JohnRSmith101/rocket-tracker/hardware/kicad/Gimbal_Controller_Box_R1/Gimbal Controller Box R1.jpg

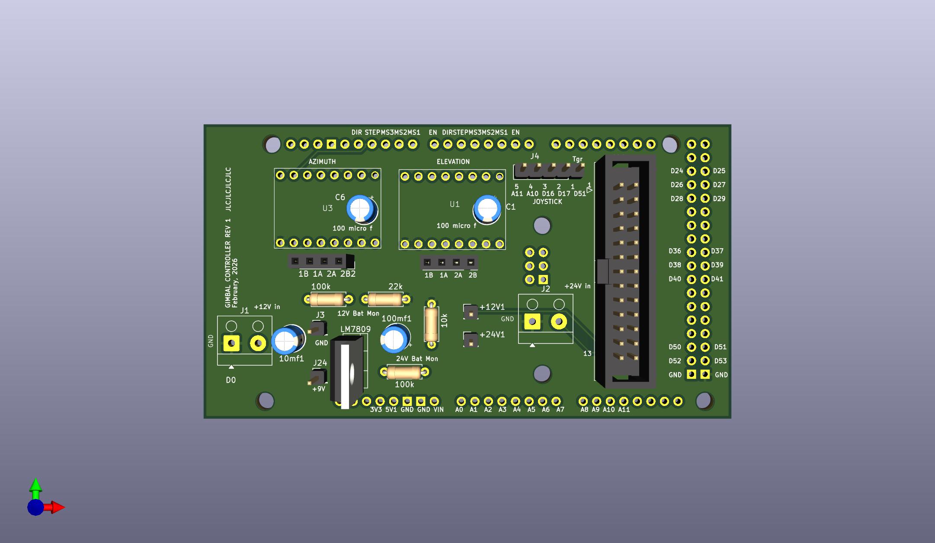
hardware/kicad/Gimbal_Controller_Box_R1/Gimbal Controller Box R1.jpg
