JohnRSmith101/rocket-tracker/hardware/kicad/Gimbal_Controller_Lid/Gimbal Controller Lid.jpg

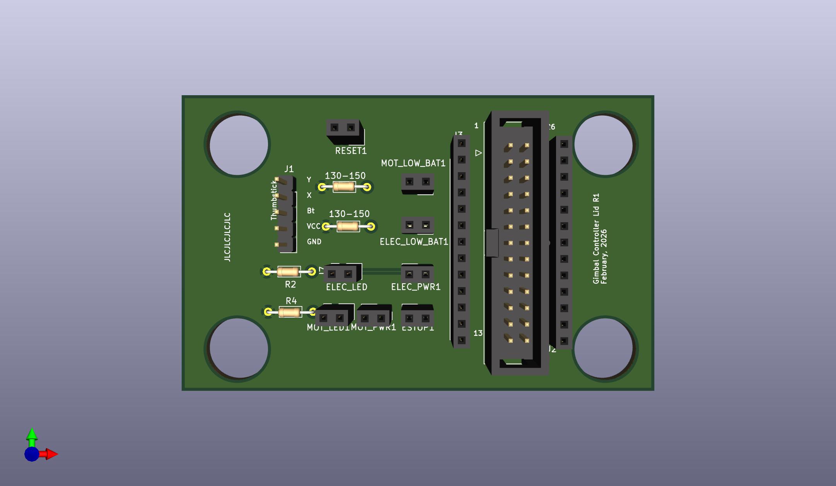
hardware/kicad/Gimbal_Controller_Lid/Gimbal Controller Lid.jpg
