JohnRSmith101/rocket-tracker/LICENSES/README.md

# License texts

| File | License | Applies to |
|---|---|---|
| `Apache-2.0.txt` | Apache License 2.0 | Arduino sketches, TFLite tracker, TFLite/MediaPipe models |
| `AGPL-3.0-only.txt` | GNU AGPL v3 | YOLO tracker and YOLO models |
| `CC-BY-SA-4.0.txt` | CC BY-SA 4.0 | Build Book, KiCad, STL, photos, drawings, datasets |
| `MIT-RamadityaK.txt` | MIT (third party) | Notice for PiMediapipeObjectDetection by Ramaditya Kotha |

See `../LICENSE` for which license applies to which folder.
