JohnRSmith101/rocket-tracker/models/mediapipe-dec2024/training-records/colab_log_earlier_small_dataset_rocket8_166_images.pdf

### You are subscribed to

Colab Pro.

### Learn more (https://colab.research.google.com/signup?authuser=1) Available:

143.81

### compute units Usage rate: approximately 0 per hour You have 0 active

sessions.

### Not connected

to runtime.

OOppeenn iinn CCoollaabb (https://colab.research.google.com/github/khanhlvg/tflite_raspberry_pi/blob/main/object_detection/Train_custom_model_tutorial.ipynb)

- Copyright 2023 The MediaPipe Authors.

# Licensed under the Apache License, Version 2.0 (the

"License");

### Show code

In this colab notebook, you'll learn how to use MediaPipe Model Maker (https://developers.google.com/mediapipe/solutions/model_maker) to train a custom object detection model to detect dogs.

## The Model Maker library uses transfer learning to simplify the process of training a TensorFlow Lite model using a custom dataset to use with the

MediaPipe Object Detector task. (https://developers.google.com/mediapipe/solutions/vision/object_detector)

# Train a custom object detection model with MediaPipe Model Maker

# Install the required packages

## Start by installing the required packages, including the Model Maker package

from the GitHub repo (https://github.com/google/mediapipe/tree/master/mediapipe/model_maker) and the pycocotools library you'll use for evaluation.

# - Preparation

Start coding or generate with AI.

Collecting colorama (from sacrebleu->tf-models-official<2.16.0,>=2.13.2->mediapipe-model-maker)

### Downloading colorama-0.4.6-py2.py3-none-any.whl.metadata (17 kB)

Requirement already satisfied: lxml in /usr/local/lib/python3.10/dist-packages (from sacrebleu->tf-models-official<2.16.0,>=2.13.2->mediapipe-model-maker) (5.3.0)
Requirement already satisfied: scikit-learn>=0.21.3 in /usr/local/lib/python3.10/dist-packages (from seqeval->tf-models-official<2.16.0,>=2.13.2->mediapipe-model-maker) (1.5.2)

### !pip install --upgrade pip !pip install 'keras<3.0.0' mediapipe-model-maker

### Manage sessions

### Change runtime type

### Resources

Requirement already satisfied: docstring-parser<1.0,>=0.15 in /usr/local/lib/python3.10/dist-packages (from simple-parsing->tensorflow-datasets->mediapipe-model-maker) (0.16)
Requirement already satisfied: googleapis-common-protos<2,>=1.52.0 in /usr/local/lib/python3.10/dist-packages (from tensorflow-metadata->tensorflow-datasets->mediapipe-model-maker) (1.66.0)
Requirement already satisfied: pycparser in /usr/local/lib/python3.10/dist-packages (from CFFI>=1.0->sounddevice>=0.4.4->mediapipe>=0.10.0->mediapipe-model-maker) (2.22)
Requirement already satisfied: proto-plus<2.0.0dev,>=1.22.3 in /usr/local/lib/python3.10/dist-packages (from google-api-core!=2.0.*,!=2.1.*,!=2.2.*,!=2.3.0,<3.0.0.dev0,>=1.31.5->google-api-python-client>=1.6.7->tf-models-official<2.16.0,>=2.13.2->mediapipe-model-maker) (1.25.0) Requirement already satisfied: cachetools<6.0,>=2.0.0 in /usr/local/lib/python3.10/dist-packages (from google-auth!=2.24.0,!=2.25.0,<3.0.0.dev0,>=1.32.0->google-api-python-client>=1.6.7->tf-models-official<2.16.0,>=2.13.2->mediapipe-model-maker) (5.5.0)
Requirement already satisfied: requests-oauthlib>=0.7.0 in /usr/local/lib/python3.10/dist-packages (from google-auth-oauthlib<2,>=0.5->tensorboard<2.16,>=2.15->tensorflow<2.16,>=2.10->mediapipe-model-maker) (1.3.1)
Requirement already satisfied: joblib>=1.2.0 in /usr/local/lib/python3.10/dist-packages (from scikit-learn>=0.21.3->seqeval->tf-models-official<2.16.0,>=2.13.2->mediapipe-model-maker) (1.4.2)
Requirement already satisfied: threadpoolctl>=3.1.0 in /usr/local/lib/python3.10/dist-packages (from scikit-learn>=0.21.3->seqeval->tf-models-official<2.16.0,>=2.13.2->mediapipe-model-maker) (3.5.0)
Requirement already satisfied: MarkupSafe>=2.1.1 in /usr/local/lib/python3.10/dist-packages (from werkzeug>=1.0.1->tensorboard<2.16,>=2.15->tensorflow<2.16,>=2.10->mediapipe-model-maker) (3.0.2)
Requirement already satisfied: webencodings in /usr/local/lib/python3.10/dist-packages (from bleach->kaggle>=1.3.9->tf-models-official<2.16.0,>=2.13.2->mediapipe-model-maker) (0.5.1)
Requirement already satisfied: text-unidecode>=1.3 in /usr/local/lib/python3.10/dist-packages (from python-slugify->kaggle>=1.3.9->tf-models-official<2.16.0,>=2.13.2->mediapipe-model-maker) (1.3)
Requirement already satisfied: oauthlib>=3.0.0 in /usr/local/lib/python3.10/dist-packages (from requests-oauthlib>=0.7.0->google-auth-oauthlib<2,>=0.5->tensorboard<2.16,>=2.15->tensorflow<2.16,>=2.10->mediapipe-model-maker) (3.2.2)

Downloading keras-2.15.0-py3-none-any.whl (1.7 MB) ━━━━━━━━━━━━━━━━━━━━━━━━━━━━━━━━━━━━━━━━ 1.7/1.7 MB 40.5 MB/s Downloading mediapipe_model_maker-0.2.1.4-py3-none-any.whl (133 kB) Downloading mediapipe-0.10.20-cp310-cp310-manylinux_2_28_x86_64.whl (35.6 MB) ━━━━━━━━━━━━━━━━━━━━━━━━━━━━━━━━━━━━━━━━ 35.6/35.6 MB 107.3 MB/s

Downloading tensorflow-2.15.1-cp310-cp310-manylinux_2_17_x86_64.manylinux2014_x86_64.whl (475.2 MB)

### ━━━━━━━━━━━━━━━━━━━━━━━━━━━━━━━━━━━━━━━━ 475.2/475.2 MB 49.7 MB/s Downloading tensorflow_model_optimization-0.7.5-py2.py3-none-any.whl (241 kB) Downloading tf_models_official-2.15.0-py2.py3-none-any.whl (2.7 MB) ━━━━━━━━━━━━━━━━━━━━━━━━━━━━━━━━━━━━━━━━ 2.7/2.7 MB 61.9 MB/s

Downloading tensorflow_text-2.15.0-cp310-cp310-manylinux_2_17_x86_64.manylinux2014_x86_64.whl (5.2 MB)

### ━━━━━━━━━━━━━━━━━━━━━━━━━━━━━━━━━━━━━━━━ 5.2/5.2 MB 73.5 MB/s

Downloading tensorflow_addons-0.23.0-cp310-cp310-manylinux_2_17_x86_64.manylinux2014_x86_64.whl (611 kB)

### ━━━━━━━━━━━━━━━━━━━━━━━━━━━━━━━━━━━━━━━━ 611.8/611.8 kB 25.5 MB/s

Downloading ml_dtypes-0.3.2-cp310-cp310-manylinux_2_17_x86_64.manylinux2014_x86_64.whl (2.2 MB)

━━━━━━━━━━━━━━━━━━━━━━━━━━━━━━━━━━━━━━━━ 2.2/2.2 MB 65.1 MB/s Downloading sounddevice-0.5.1-py3-none-any.whl (32 kB) Downloading tensorboard-2.15.2-py3-none-any.whl (5.5 MB) ━━━━━━━━━━━━━━━━━━━━━━━━━━━━━━━━━━━━━━━━ 5.5/5.5 MB 90.3 MB/s Downloading tensorflow_estimator-2.15.0-py2.py3-none-any.whl (441 kB) Downloading tf_keras-2.15.1-py3-none-any.whl (1.7 MB) ━━━━━━━━━━━━━━━━━━━━━━━━━━━━━━━━━━━━━━━━ 1.7/1.7 MB 61.2 MB/s Downloading typeguard-2.13.3-py3-none-any.whl (17 kB)

Downloading wrapt-1.14.1-cp310-cp310-manylinux_2_5_x86_64.manylinux1_x86_64.manylinux_2_17_x86_64.manylinux2014_x86_64.whl (77 kB)

### Downloading sacrebleu-2.4.3-py3-none-any.whl (103 kB) Downloading colorama-0.4.6-py2.py3-none-any.whl (25 kB) Downloading portalocker-3.0.0-py3-none-any.whl (19 kB) Building wheels for collected packages: seqeval Building wheel for seqeval (setup.py) ... done

Created wheel for seqeval: filename=seqeval-1.2.2-py3-none-any.whl size=16161 sha256=df015b97a5ea490875526c99ecec4c3634c298cd50fbd425cc0a688eb1be956b
Stored in directory: /root/.cache/pip/wheels/1a/67/4a/ad4082dd7dfc30f2abfe4d80a2ed5926a506eb8a972b4767fa

### Successfully built seqeval

Installing collected packages: wrapt, typeguard, tensorflow-model-optimization, tensorflow-estimator, portalocker, ml-dtypes, keras, colorama, tensorflow-addons, sounddevice, sacrebleu, seqeval, tensorboard, mediapipe, tensorflow, tf-keras, tensorflow-text, tf-models-official, mediapipe-model-maker

### Attempting uninstall: wrapt Found existing installation: wrapt 1.17.0 Uninstalling wrapt-1.17.0: Successfully uninstalled wrapt-1.17.0 Attempting uninstall: typeguard Found existing installation: typeguard 4.4.1 Uninstalling typeguard-4.4.1: Successfully uninstalled typeguard-4.4.1

### Attempting uninstall: ml-dtypes

Import the required packages.

/usr/local/lib/python3.10/dist-packages/tensorflow_addons/utils/tfa_eol_msg.py:23: UserWarning:

TensorFlow Addons (TFA) has ended development and introduction | of new features.
TFA has entered a minimal maintenance and release mode until | a | planned end of life in May 2024.
Please modify downstream libraries to take dependencies from | other repositories | in our TensorFlow community (e.g. Keras, Keras-CV, and Keras-NLP).

### For more information see: https://github.com/tensorflow/addons/issues/2807

### warnings.warn(

### import os import tensorflow as tf assert tf.__version__.startswith('2') from google.colab import files

### from mediapipe_model_maker import object_detector

## This dataset contains about 130 images of 3 different dogs: a Golden Retriever, a Labrador Retriever mix, and a brindle-colored Formosan Mountain

Dog. This is an example image from the dataset.

# - Prepare the dataset

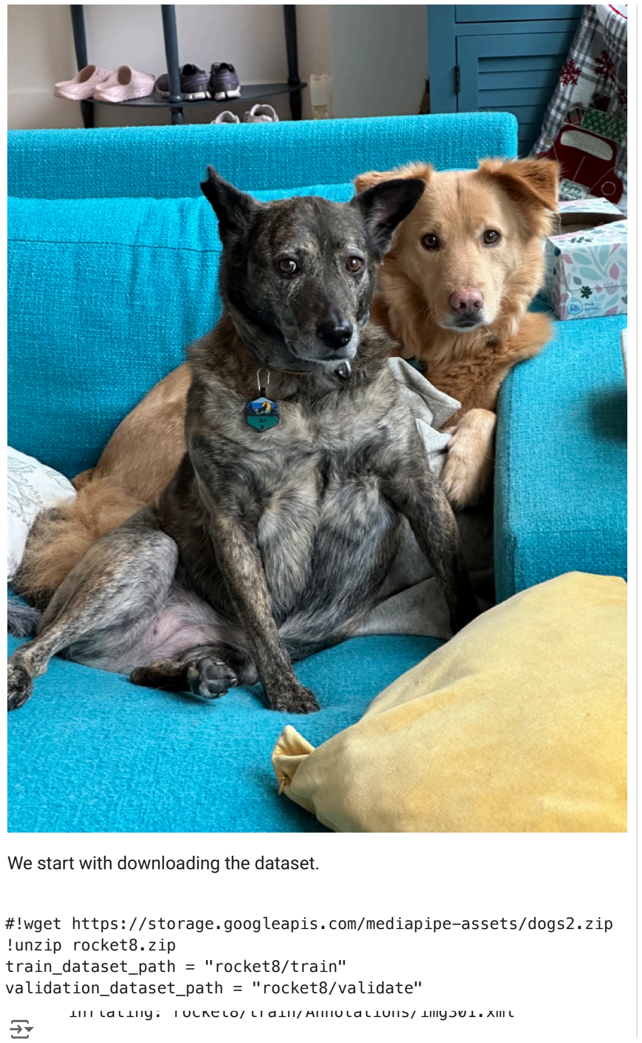
[picture p3: figure]
We start with downloading the dataset.; !unzip rocket8.zip train_dataset_path = "rocket8/train"

### inflating: rocket8/train/Annotations/img301.xml

### #!wget https://storage.googleapis.com/mediapipe-assets/dogs2.zip --no-check-certificate

### validation_dataset_path = "rocket8/validate"

inflating: __MACOSX/rocket8/train/Annotations/._img301.xml inflating: rocket8/train/Annotations/img329.xml inflating: __MACOSX/rocket8/train/Annotations/._img329.xml inflating: rocket8/train/Annotations/img117.xml inflating: __MACOSX/rocket8/train/Annotations/._img117.xml inflating: rocket8/train/Annotations/img103.xml inflating: __MACOSX/rocket8/train/Annotations/._img103.xml inflating: rocket8/train/Annotations/img129.xml inflating: __MACOSX/rocket8/train/Annotations/._img129.xml inflating: rocket8/train/Annotations/img115.xml inflating: __MACOSX/rocket8/train/Annotations/._img115.xml inflating: rocket8/train/Annotations/img101.xml inflating: __MACOSX/rocket8/train/Annotations/._img101.xml inflating: rocket8/train/Annotations/img459.xml inflating: __MACOSX/rocket8/train/Annotations/._img459.xml inflating: rocket8/train/Annotations/img471.xml inflating: __MACOSX/rocket8/train/Annotations/._img471.xml inflating: rocket8/train/Annotations/img303.xml inflating: __MACOSX/rocket8/train/Annotations/._img303.xml inflating: rocket8/train/Annotations/img465.xml inflating: __MACOSX/rocket8/train/Annotations/._img465.xml inflating: rocket8/train/Annotations/img539.xml inflating: __MACOSX/rocket8/train/Annotations/._img539.xml inflating: rocket8/train/Annotations/img505.xml inflating: __MACOSX/rocket8/train/Annotations/._img505.xml inflating: rocket8/train/Annotations/img263.xml inflating: __MACOSX/rocket8/train/Annotations/._img263.xml inflating: rocket8/train/Annotations/img277.xml inflating: __MACOSX/rocket8/train/Annotations/._img277.xml inflating: rocket8/train/Annotations/img511.xml inflating: __MACOSX/rocket8/train/Annotations/._img511.xml inflating: rocket8/train/Annotations/img288.xml inflating: __MACOSX/rocket8/train/Annotations/._img288.xml inflating: rocket8/train/Annotations/img289.xml inflating: __MACOSX/rocket8/train/Annotations/._img289.xml inflating: rocket8/train/Annotations/img276.xml inflating: __MACOSX/rocket8/train/Annotations/._img276.xml inflating: rocket8/train/Annotations/img510.xml inflating: __MACOSX/rocket8/train/Annotations/._img510.xml inflating: rocket8/train/Annotations/img504.xml inflating: __MACOSX/rocket8/train/Annotations/._img504.xml inflating: rocket8/train/Annotations/img262.xml inflating: __MACOSX/rocket8/train/Annotations/._img262.xml inflating: rocket8/train/Annotations/img538.xml inflating: __MACOSX/rocket8/train/Annotations/._img538.xml inflating: rocket8/train/Annotations/img13.xml inflating: __MACOSX/rocket8/train/Annotations/._img13.xml inflating: rocket8/train/Annotations/img302.xml inflating: __MACOSX/rocket8/train/Annotations/._img302.xml inflating: rocket8/train/Annotations/img464.xml inflating: __MACOSX/rocket8/train/Annotations/._img464.xml inflating: rocket8/train/Annotations/img470.xml inflating: __MACOSX/rocket8/train/Annotations/._img470.xml

### options=options)

### inflating: rocket8/train/Annotations/img316.xml inflating: __MACOSX/rocket8/train/Annotations/._img316.xml inflating: rocket8/train/Annotations/img458.xml inflating: __MACOSX/rocket8/train/Annotations/._img458.xml inflating: rocket8/train/Annotations/img114.xml

# Step 1: Load the dataset

## Images in train_data is used to train the custom object detection

model.

## Images in val_data is used to check if the model can generalize well

to new images that it hasn't seen before.

# - Train the object detection model

### train_data = object_detector.Dataset.from_pascal_voc_folder(

'rocket8/train',
cache_dir="/tmp/od_data/train",
)

### val_data = object_detector.Dataset.from_pascal_voc_folder(

'rocket8/validate',

### cache_dir="/tmp/od_data/validatation")

## Set batch_size = 8 here so you will see that it takes 13 steps to go

through the 139 images in the training dataset.

## Set learning_rate = 0.3 here so the model will adjust its weights at

a rate of 0.3.

## Set epochs = 50 , which means it will go through the training dataset 50 times. You can look at the validation accuracy during training and stop when you see validation loss ( val_loss ) stop decreasing to avoid

over`tting.

- Step 2: Train the TensorFlow model with the training data.

hparams = object_detector.HParams(batch_size=8, learning_rate=0.3,

### options = object_detector.ObjectDetectorOptions(

supported_model=object_detector.SupportedModels.MOBILENET_V2,

### hparams=hparams

)

### model = object_detector.ObjectDetector.create(

/usr/local/lib/python3.10/dist-packages/keras/src/engine/functional.py:642: UserWarning: Input dict contained keys ['6'] which did not match any model input. They will be ignored by the model.

### inputs = self._flatten_to_reference_inputs(inputs)

WARNING:tensorflow:`tf.keras.layers.experimental.SyncBatchNormalization` endpoint is deprecated and will be removed in a future release. Please use `tf.keras.layers.BatchNormalization` with parameter `synchronized` set to True. Downloading https://storage.googleapis.com/tf_model_garden/vision/qat/mobilenetv2_ssd_coco/mobilenetv2_ssd_i256_ckpt.tar.gz

### Model: "retina_net_model" _________________________________________________________________

Layer (type) | Output Shape | Param | #
=================================================================
mobile_net (MobileNet) | {'2': (None, 64, 64, 24 | 2257984
| ), '3': (None, 32, 32, 32 ), '4': (None, 16, 16, 96 ), '5': (None, 8, 8, 320) , '6': (None, 8, 8, 128 0)}
fpn (FPN) | {'5': (None, 8, 8, 128) | 149056
| , '4': (None, 16, 16, 1 28), '3': (None, 32, 32, 12 8), '6': (None, 4, 4, 128) , '7': (None, 2, 2, 128 )}
multilevel_detection_gener multiple | 0 (unused)

### ator (MultilevelDetectionG enerator)

retina_net_head (RetinaNet ({'3': (None, 32, 32, 8 | 179189
Head) | 1), '4': (None, 16, 16, 81 ), '5': (None, 8, 8, 81), '6': (None, 4, 4, 81), '7': (None, 2, 2, 81)} , {'3': (None, 32, 32, 36), '4': (None, 16, 16, 36 ), '5': (None, 8, 8, 36), '6': (None, 4, 4, 36), '7': (None, 2, 2, 36)} , {})

=================================================================

### Total params: 2586229 (9.87 MB)

train_data=train_data,
validation_data=val_data,

### options=options)

### Trainable params: 2540597 (9.69 MB) Non-trainable params: 45632 (178.25 KB) _________________________________________________________________ Epoch 1/50

/usr/local/lib/python3.10/dist-packages/keras/src/backend.py:452: UserWarning: `tf.keras.backend.set_learning_phase` is deprecated and will be removed after 2020-10-11. To update it, simply pass a True/False value to the `training` argument of the `__call__` method of your layer or model.

### warnings.warn(

WARNING:tensorflow:Gradients do not exist for variables ['conv2dbn_block_1/batch_normalization/gamma:0', 'conv2dbn_block_1/batch_normalization/beta:0'] when minimizing the loss. If you're using `model.compile()`, did you forget to provide a `loss` argument?
WARNING:tensorflow:Gradients do not exist for variables ['conv2dbn_block_1/batch_normalization/gamma:0', 'conv2dbn_block_1/batch_normalization/beta:0'] when minimizing the loss. If you're using `model.compile()`, did you forget to provide a `loss` argument?
WARNING:tensorflow:Gradients do not exist for variables ['conv2dbn_block_1/batch_normalization/gamma:0', 'conv2dbn_block_1/batch_normalization/beta:0'] when minimizing the loss. If you're using `model.compile()`, did you forget to provide a `loss` argument? WARNING:tensorflow:Gradients do not exist for variables ['conv2dbn_block_1/batch_normalization/gamma:0', 'conv2dbn_block_1/batch_normalization/beta:0'] when minimizing the loss. If you're using `model.compile()`, did you forget to provide a `loss` argument?

## After training the object detection model using the images in the training dataset, use the 27 images in the validation dataset to evaluate how the

model performs against new data it has never seen before.

## The evaluation metrics are same as COCO. (https://cocodataset.org/#detection-eval)

- Step 3. Evaluate the model with the validation data.

17/17 [==============================] - 3s 91ms/step - total_loss: 0.7393 - cls_loss: 0.4557 - box_loss: 0.0046 - model_loss: 0.6834 creating index...

### index created!

creating index...

### index created!

Running per image evaluation...

### Evaluate annotation type *bbox*

DONE (t=0.31s).
Accumulating evaluation results...
DONE (t=0.12s).
Average Precision (AP) @[ IoU=0.50:0.95 | area= | all | maxDets=100 ] = 0.399
Average Precision (AP) @[ IoU=0.50 | | area= | all | maxDets=100 ] = 0.875
Average Precision (AP) @[ IoU=0.75 | | area= | all | maxDets=100 ] = 0.251

### Average Precision (AP) @[ IoU=0.50:0.95 | area= small | maxDets=100 ] = -1.000 Average Precision (AP) @[ IoU=0.50:0.95 | area=medium | maxDets=100 ] = 0.358 Average Precision (AP) @[ IoU=0.50:0.95 | area= large | maxDets=100 ] = 0.445

Average Recall | (AR) @[ IoU=0.50:0.95 | area= | all | maxDets= 1 ] = 0.475
Average Recall | (AR) @[ IoU=0.50:0.95 | area= | all | maxDets= 10 ] = 0.502
Average Recall | (AR) @[ IoU=0.50:0.95 | area= | all | maxDets=100 ] = 0.502
Average Recall | (AR) @[ IoU=0.50:0.95 | area= small | maxDets=100 ] = -1.000
Average Recall | (AR) @[ IoU=0.50:0.95 | area=medium | maxDets=100 ] = 0.450
Average Recall | (AR) @[ IoU=0.50:0.95 | area= large | maxDets=100 ] = 0.515
Validation loss: [0.7392598986625671, 0.4557432532310486, 0.004553032573312521, | 0.6833949089050293]
Validation coco metrics: {'AP': 0.39894685, 'AP50': 0.87520427, 'AP75': 0.25061744, 'APs': -1.0, 'APm': 0.35847133, 'APl': 0.44482604, 'ARmax1': 0.47535715, 'ARmax10': 0.50223213, 'ARmax100': 0.50223213, 'ARs': -1.0, 'ARm': 0.45048952, 'ARl': 0.51458335}

### loss, coco_metrics = model.evaluate(val_data, batch_size=4) print(f"Validation loss: {loss}") print(f"Validation coco metrics: {coco_metrics}")

## After creating the model, convert and export it to a Tensorcow Lite model format, and then download it for later use in an on-device application with

MediaPipe Tasks.

- Step 4: Export as a TensorFlow Lite model.

Exporting a floating point model
/usr/local/lib/python3.10/dist-packages/keras/src/engine/functional.py:642: UserWarning: Input dict contained keys ['6'] which did not match any model input. They will be ignored by the model. inputs = self._flatten_to_reference_inputs(inputs)
/usr/local/lib/python3.10/dist-packages/keras/src/engine/functional.py:642: UserWarning: Input dict contained keys ['6'] which did not match any model input. They will be ignored by the model. inputs = self._flatten_to_reference_inputs(inputs)
WARNING:tensorflow:Skipping full serialization of Keras layer | <official.vision.modeling.retinanet_model.RetinaNetModel object at 0x7c9e919bb130>, because it is not built.
WARNING:tensorflow:Skipping full serialization of Keras layer | <keras.src.layers.merging.add.Add object at 0x7c9df3fd9f60>, because it is not built.
WARNING:tensorflow:Skipping full serialization of Keras layer | <keras.src.layers.merging.add.Add object at 0x7c9df3fc50f0>, because it is not built.
WARNING:tensorflow:Skipping full serialization of Keras layer | <keras.src.layers.merging.add.Add object at 0x7c9de00aac20>, because it is not built.
WARNING:tensorflow:Skipping full serialization of Keras layer | <keras.src.layers.merging.add.Add object at 0x7c9de577d360>, because it is not built.
WARNING:tensorflow:Skipping full serialization of Keras layer | <keras.src.layers.merging.add.Add object at 0x7c9dae572b30>, because it is not built.
WARNING:tensorflow:Skipping full serialization of Keras layer | <keras.src.layers.merging.add.Add object at 0x7c9dae5fbfa0>, because it is not built.
WARNING:tensorflow:Skipping full serialization of Keras layer | <keras.src.layers.merging.add.Add object at 0x7c9d9d371ff0>, because it is not built.
WARNING:tensorflow:Skipping full serialization of Keras layer | <official.vision.modeling.layers.detection_generator.MultilevelDetectionGenerator object at 0x7c9ce5b19960>, because it is not built.
WARNING:absl:Importing a function (__inference_internal_grad_fn_1100115) with ops with unsaved custom gradients. Will likely fail if a gradient is requested.
WARNING:absl:Importing a function (__inference_internal_grad_fn_1098693) with ops with unsaved custom gradients. Will likely fail if a gradient is requested.
WARNING:absl:Importing a function (__inference_internal_grad_fn_1103625) with ops with unsaved custom gradients. Will likely fail if a gradient is requested.
WARNING:absl:Importing a function (__inference_internal_grad_fn_1103688) with ops with unsaved custom gradients. Will likely fail if a gradient is requested. WARNING:absl:Importing a function (__inference_internal_grad_fn_1103589) with ops with unsaved custom gradients. Will likely fail if a gradien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

### model.export_model('rocket8.tflite') !ls exported_model files.download('exported_model/rocket8.tflite')

WARNING:absl:Importing a function (__inference_internal_grad_fn_1099494) with ops with unsaved custom gradients. Will likely fail if a gradient is requested. WARNING:absl:Importing a function (__inference_internal_grad_fn_1099332) with ops with unsaved custom gradients. Will likely fail if a gradient is requested. WARNING:absl:Importing a function (__inference_internal_grad_fn_1097586) with ops with unsaved custom gradients. Will likely fail if a gradient is requested. WARNING:absl:Importing a function (__inference_internal_grad_fn_1102194) with ops with unsaved custom gradients. Will likely fail if a gradient is requested. WARNING:absl:Importing a function (__inference_internal_grad_fn_1096398) with ops with unsaved custom gradients. Will likely fail if a gradient is requested. WARNING:absl:Importing a function (__inference_internal_grad_fn_1101681) with ops with unsaved custom gradients. Will likely fail if a gradient is requested. WARNING:absl:Importing a function (__inference_internal_grad_fn_1101069) with ops with unsaved custom gradients. Will likely fail if a gradient is requested. WARNING:absl:Importing a function (__inference_internal_grad_fn_1104363) with ops with unsaved custom gradients. Will likely fail if a gradient is requested. WARNING:absl:Importing a function (__inference_internal_grad_fn_1099233) with ops with unsaved custom gradients. Will likely fail if a gradient is requested. WARNING:absl:Importing a function (__inference_internal_grad_fn_1102923) with 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

WARNING:absl:Importing a function (__inference_internal_grad_fn_1102707) with ops with unsaved custom gradients. Will likely fail if a gradient is requested. WARNING:absl:Importing a function (__inference_internal_grad_fn_1099764) with ops with unsaved custom gradients. Will likely fail if a gradient is requested. WARNING:absl:Importing a function (__inference_internal_grad_fn_1097370) with ops with unsaved custom gradients. Will likely fail if a gradient is requested. WARNING:absl:Importing a function (__inference_internal_grad_fn_1102563) with ops with unsaved custom gradients. Will likely fail if a gradient is requested. WARNING:absl:Importing a function (__inference_internal_grad_fn_1103877) with ops with unsaved custom gradients. Will likely fail if a gradient is requested.
dogs.tflite | float_ckpt.data-00000-of-00001 | float_ckpt.index | metadata.json | rocket8.tflite
