JohnRSmith101/rocket-tracker/datasets/examples/img380_annotated.jpg

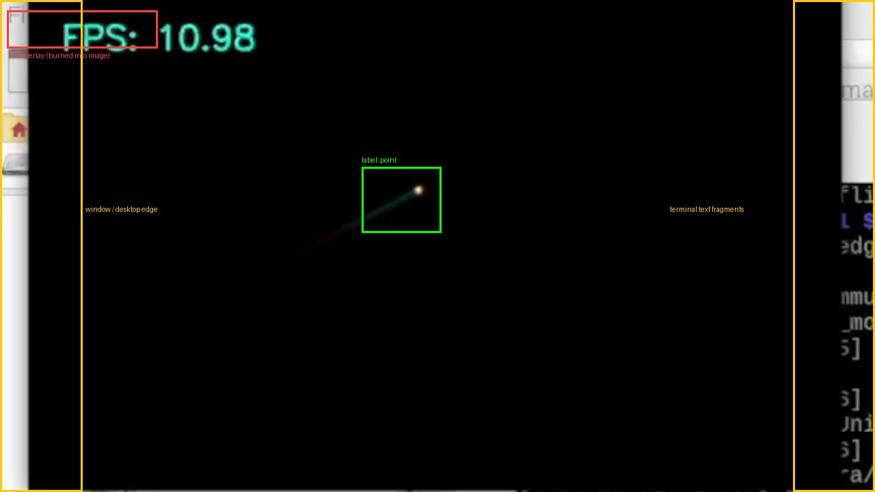
datasets/examples/img380_annotated.jpg
