JohnRSmith101/rocket-tracker/datasets/examples/img380_original.jpg

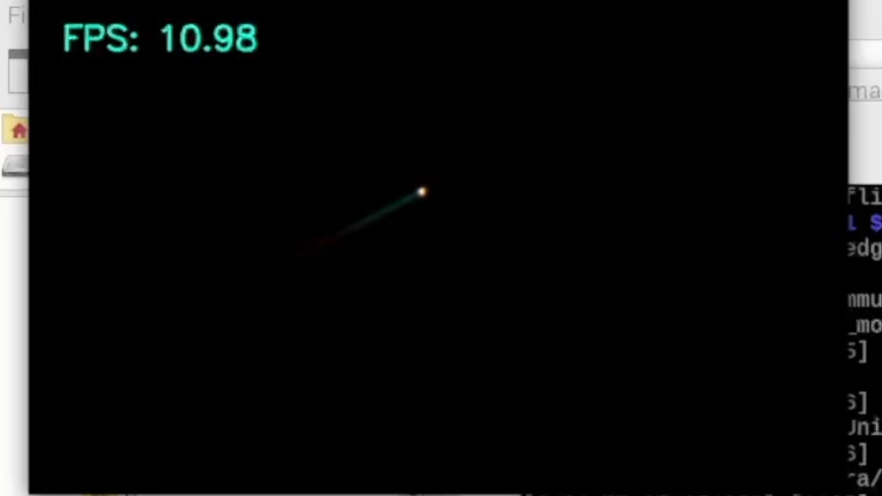
datasets/examples/img380_original.jpg
