JohnRSmith101/rocket-tracker/docs/images/LM7809_pinout.png

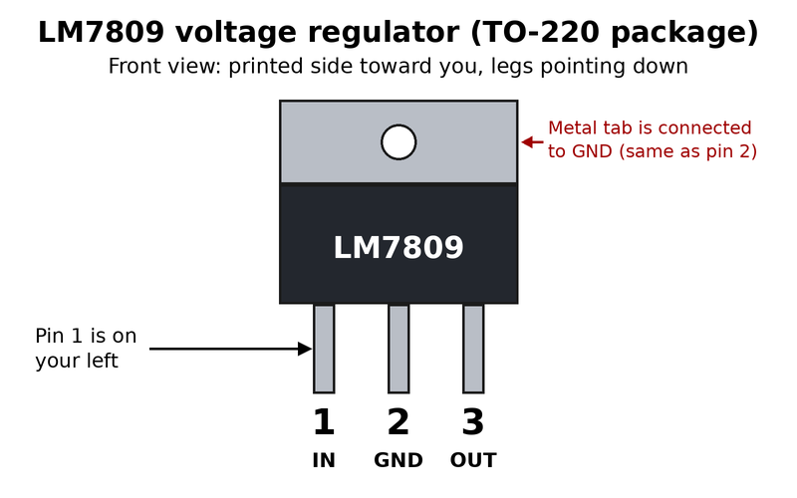
docs/images/LM7809_pinout.png
