JohnRSmith101/rocket-tracker/docs/images/telescope_rear_cell_to_camera_sensor.png

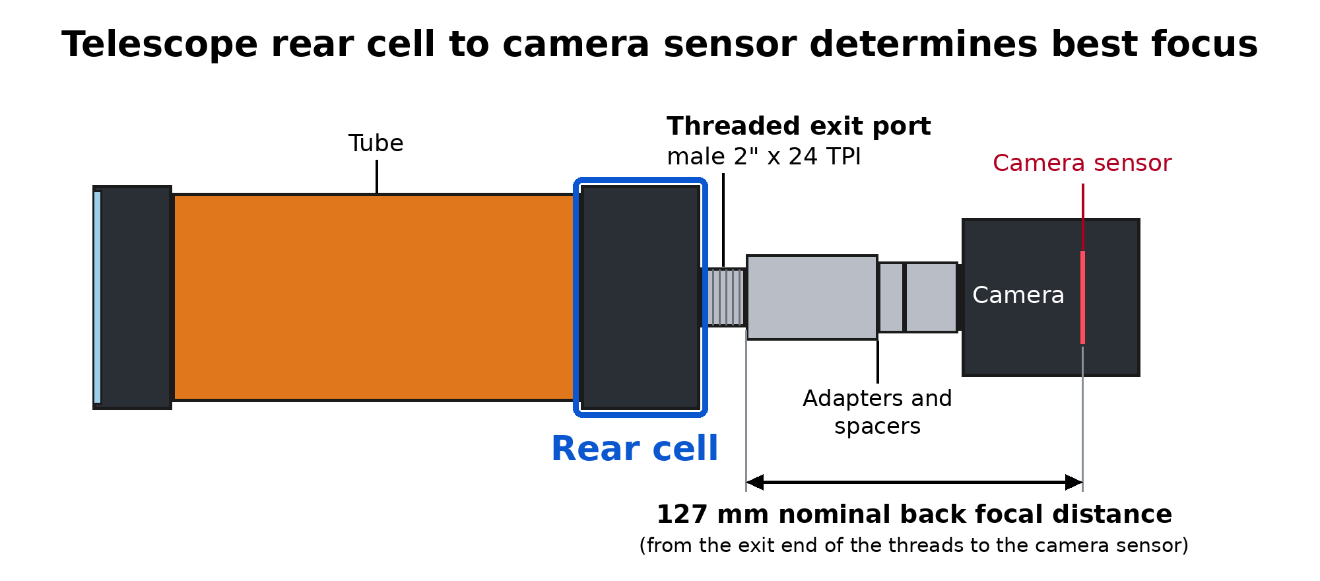
docs/images/telescope_rear_cell_to_camera_sensor.png
