JohnRSmith101/rocket-tracker/models/yolo/training-runs/yolo11n_60epochs/BoxPR_curve.png

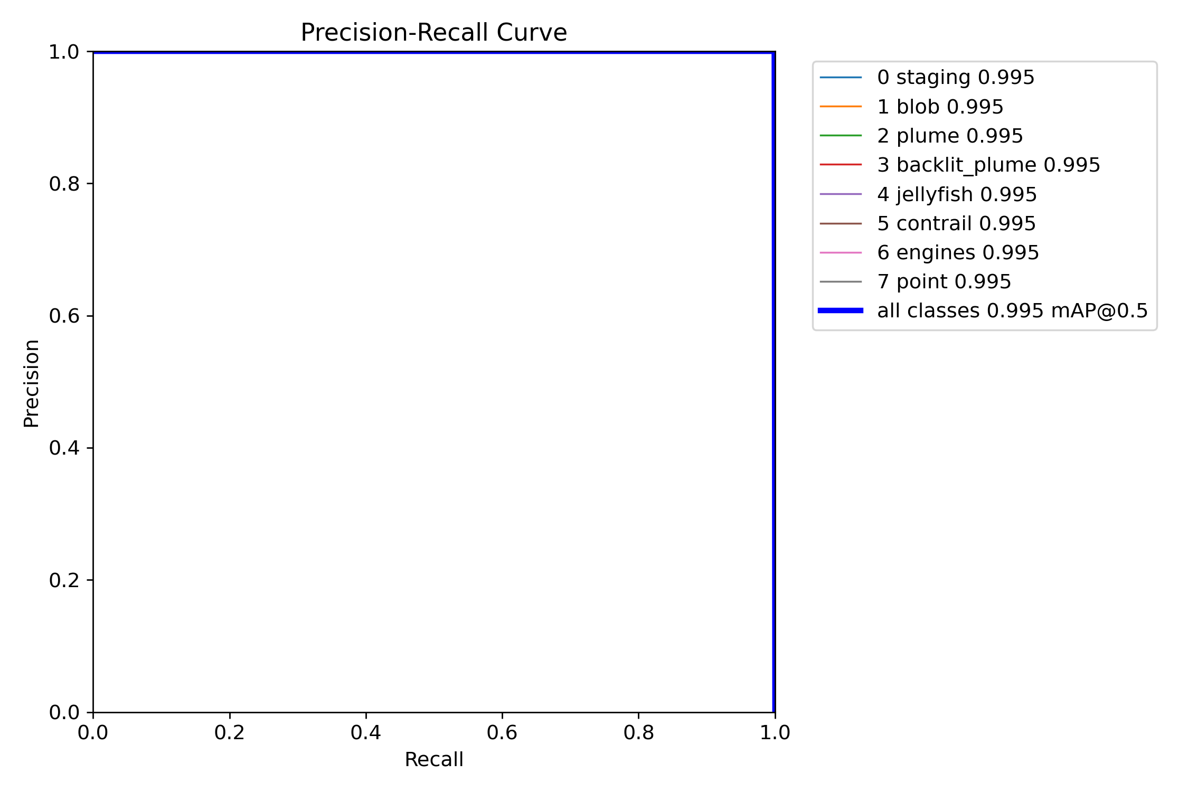
models/yolo/training-runs/yolo11n_60epochs/BoxPR_curve.png
