JohnRSmith101/rocket-tracker/models/yolo/training-runs/yolo11n_60epochs/confusion_matrix_normalized.png

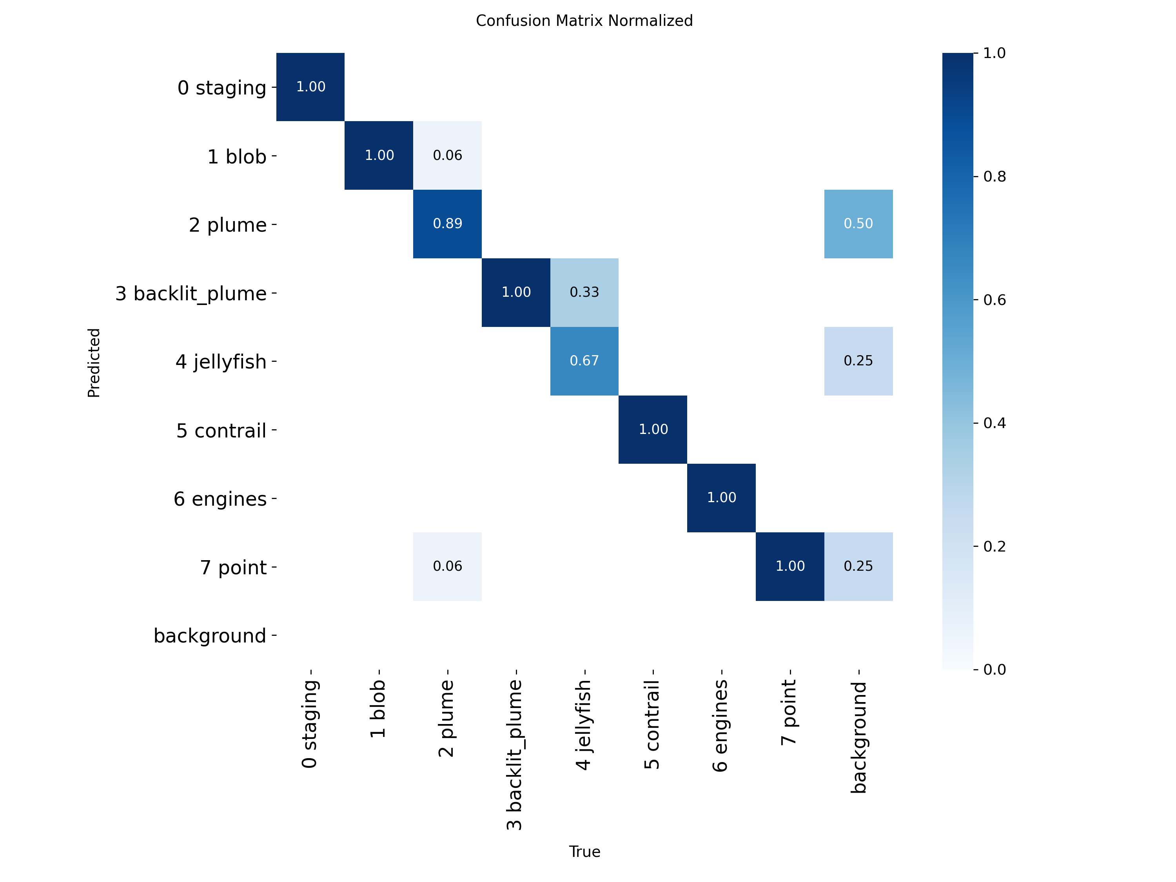
models/yolo/training-runs/yolo11n_60epochs/confusion_matrix_normalized.png
