JohnRSmith101/rocket-tracker/hardware/3d-printing/40_1_AZ_Worm_Gear_Frame/40_1_AZ_Worm_Gear_Frame.stl

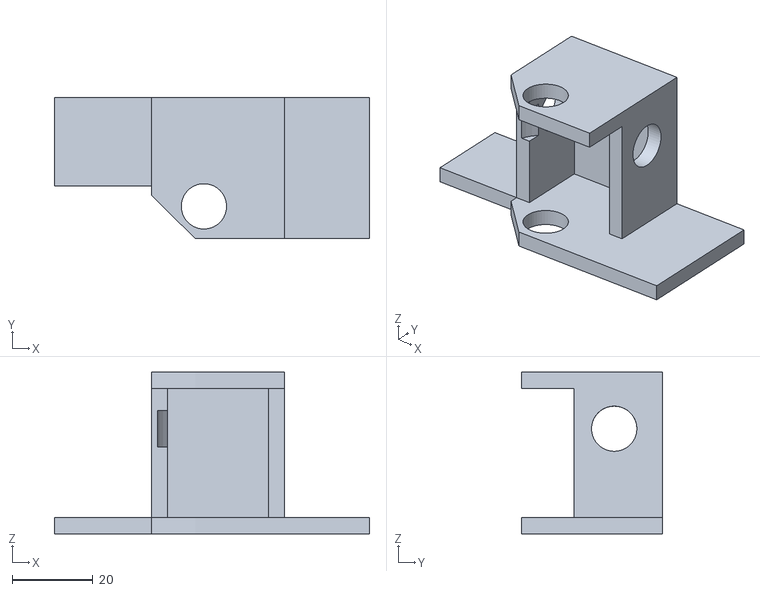
[picture p12: CAD file, 2026-11-13]
hardware/3d-printing/40_1_AZ_Worm_Gear_Frame/40_1_AZ_Worm_Gear_Frame.stl
78.0 x 35.0 x 40.0
