JohnRSmith101/rocket-tracker/hardware/3d-printing/5mm_Bearing_Bushings_for_Long_EL_Shaft/5mm_Bearing_Bushings_for_Long_EL_Shaft.stl

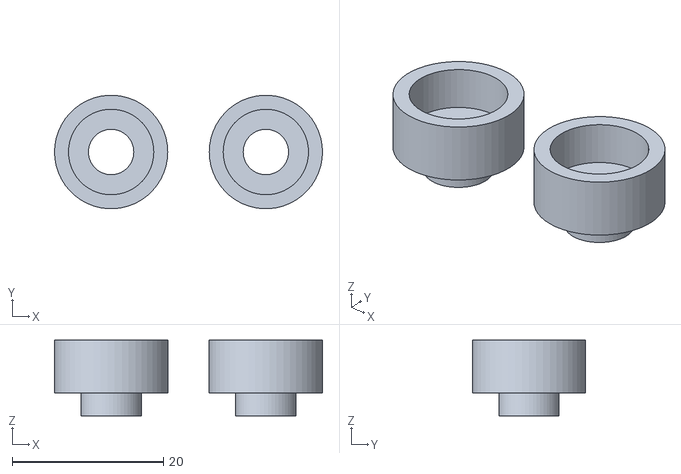
[picture p13: CAD file, 2026-11-13]
hardware/3d-printing/5mm_Bearing_Bushings_for_Long_EL_Shaft/5mm_Bearing_Bushings_for_Long_EL_Shaft.stl
35.5 x 15.0 x 10.0
