JohnRSmith101/rocket-tracker/hardware/3d-printing/60_1_EL_Worm_Gear_Frame/60_1_EL_Worm_Gear_Frame.stl

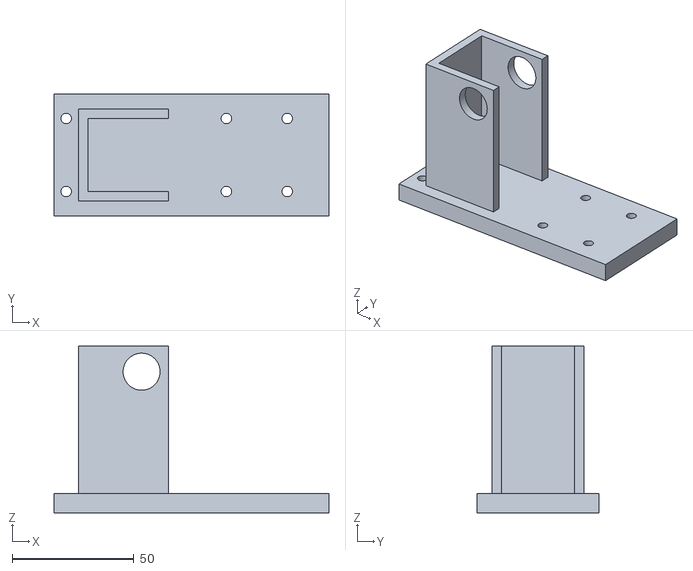
[picture p14: CAD file, 2026-11-13]
hardware/3d-printing/60_1_EL_Worm_Gear_Frame/60_1_EL_Worm_Gear_Frame.stl
113.0 x 50.0 x 68.5
