JohnRSmith101/rocket-tracker/hardware/3d-printing/AZ_Spur_Gear_Mount/AZ_Spur_Gear_Mount.stl

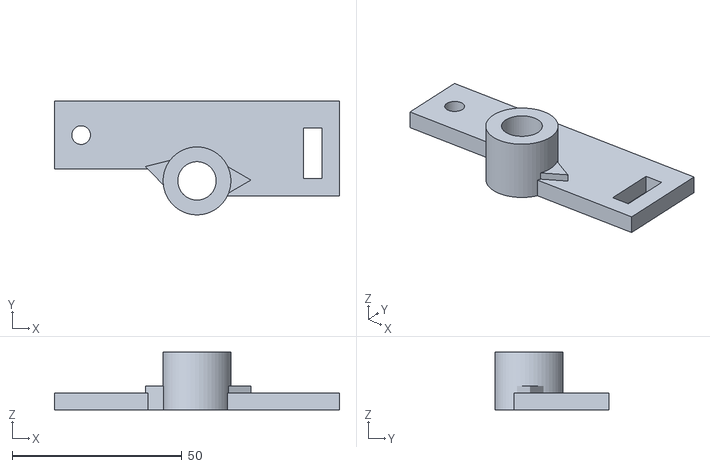
[picture p15: CAD file, 2026-11-13]
hardware/3d-printing/AZ_Spur_Gear_Mount/AZ_Spur_Gear_Mount.stl
84.0 x 33.5 x 17.0
