JohnRSmith101/rocket-tracker/hardware/3d-printing/Celestron_Arm_to_Flat_Plate/Celestron_Arm_to_Flat_Plate.stl

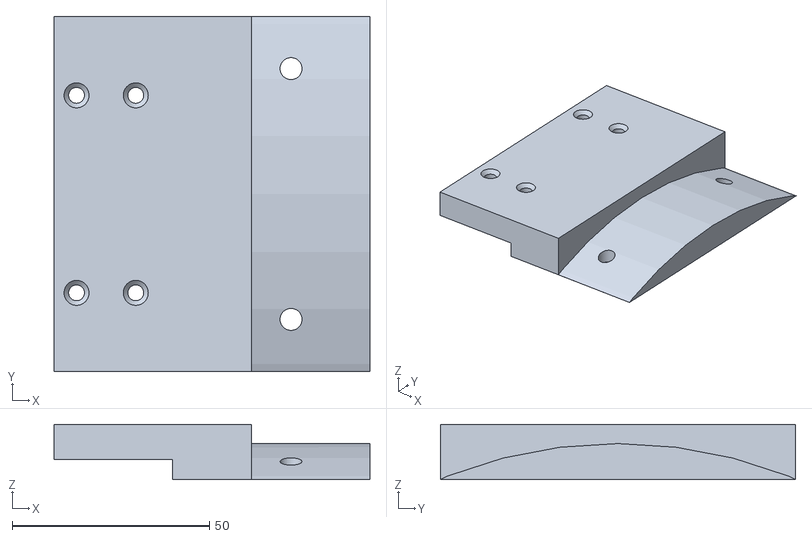
[picture p16: CAD file, 2026-11-13]
hardware/3d-printing/Celestron_Arm_to_Flat_Plate/Celestron_Arm_to_Flat_Plate.stl
80.0 x 90.0 x 14.0
