JohnRSmith101/rocket-tracker/hardware/3d-printing/Large_GT2_Pulley_for_Celestron/Large_GT2_Pulley_for_Celestron.stl

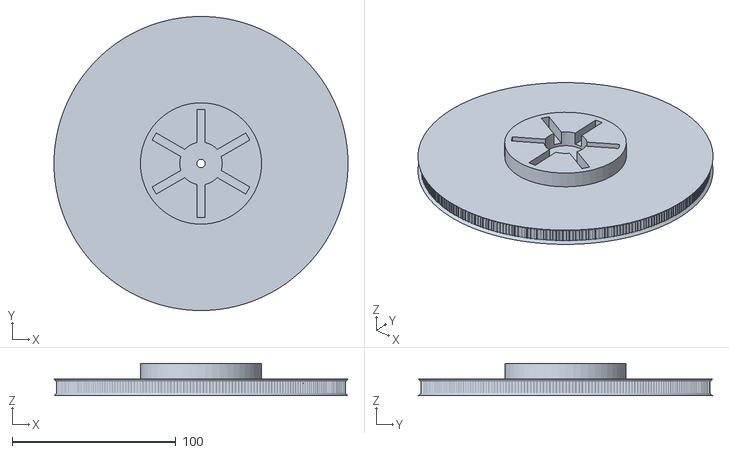
[picture p17: CAD file, 2026-11-13]
hardware/3d-printing/Large_GT2_Pulley_for_Celestron/Large_GT2_Pulley_for_Celestron.stl
179.5 x 179.5 x 19.6
