JohnRSmith101/rocket-tracker/hardware/3d-printing/Large_GT2_Pulley_Generic/Large_GT2_Pulley_Generic.stl

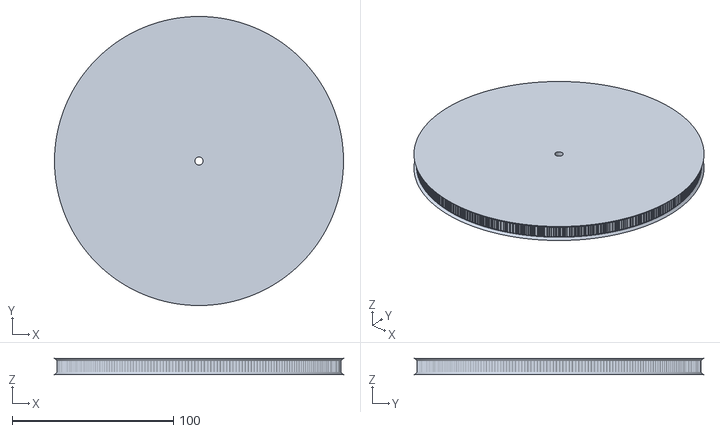
[picture p18: CAD file, 2026-11-13]
hardware/3d-printing/Large_GT2_Pulley_Generic/Large_GT2_Pulley_Generic.stl
179.5 x 179.5 x 10.0
