JohnRSmith101/rocket-tracker/models/yolo/training-runs/yolo11s_60epochs/Colab_notebook_printout.pdf

### Author: Evan Juras, EJ Technology Consultants (https://ejtech.io)

### Last updated: January 3, 2025

GitHub: Train and Deploy YOLO Models (https://github.com/EdjeElectronics/Train-and-Deploy-YOLO-Models)

# Introduction

This notebook uses Ultralytics (https://docs.ultralytics.com/) to train YOLO11, YOLOv8, or YOLOv5 object detection

### models with a custom dataset. At the end of this Colab, you'll have a custom YOLO

model that you can run on your PC, phone, or edge device like the Raspberry Pi.

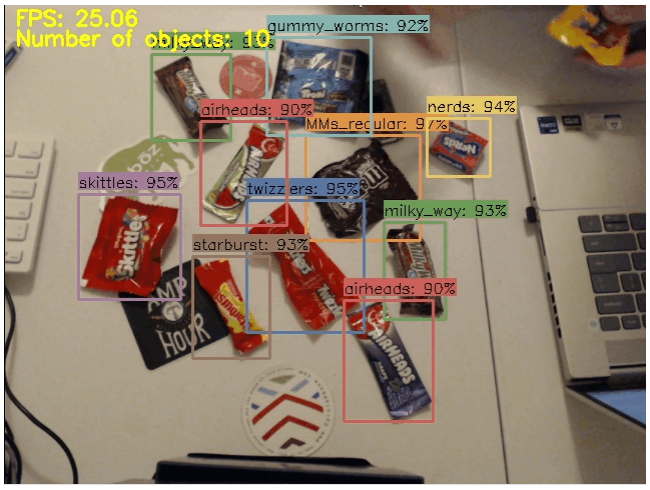
[picture p19: figure]

### Custom YOLO candy detection model in action!

### I created a YouTube video that walks through this guide step by step. I recommend

following along with the video while working through this notebook.

# - Train YOLO Models in Google Colab

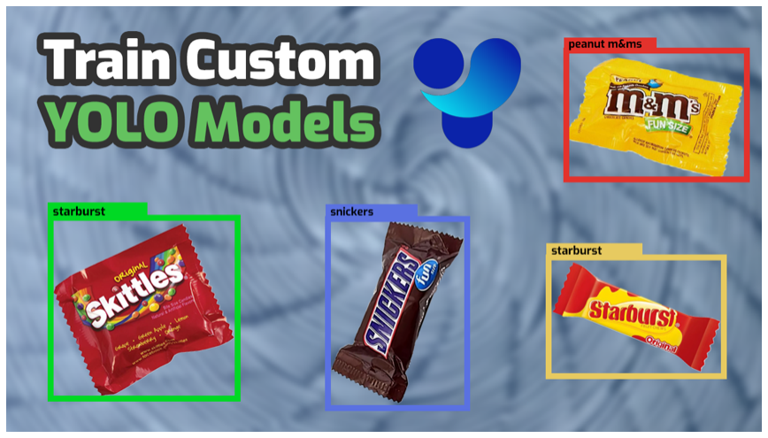
[picture p20: figure]

### Click here to go to the video! (https://youtu.be/r0RspiLG260)

### Important note: This notebook will be continuously updated to make sure it works with newer versions of Ultralytics and YOLO. If you see any di!erences between the YouTube video and this notebook, always follow the notebook!

## Working in Colab

Colab provides a virtual machine in your browser complete with a Linux OS,

### !lesystem, Python environment, and best of all, a free GPU. We'll install PyTorch and Ultralytics in this environment and use it to train our model. Simply click the Play

bu"on on sections of code in this notebook to execute them on the virtual machine.

## Navigation

### To navigate this notebook, use the table of contents in the le# sidebar to jump from

section to section.

### Verify NVIDIA GPU Availability

### Make sure you're using a GPU-equipped machine by going to "Runtime" -> "Change runtime type" in the top menu bar, and then selecting one of the GPU options in the Hardware accelerator section. Click Play on the following code block to verify that the

NVIDIA GPU is present and ready for training.

!nvidia-smi

Tue Jul 7 21:20:32 2026
+-----------------------------------------------------------------------------------------+
| NVIDIA-SMI 580.82.07 | Driver Version: 580.82.07 | CUDA Version: 13.0 | |
+-----------------------------------------+------------------------+----------------------+
| GPU Name | Persistence-M | Bus-Id | Disp.A | Volatile Uncorr. ECC |
| Fan Temp | Perf | Pwr:Usage/Cap | | Memory-Usage | GPU-Util Compute M. |
| | | | | | | | | | MIG M. |
|=========================================+========================+======================|
| | 0 Tesla T4 | Off | | 00000000:00:04.0 Off | | 0 |
| N/A | 50C | P8 | 10W / | 70W | | 0MiB / 15360MiB | | 0% | Default |
| | | | | | | | | | N/A |
+-----------------------------------------+------------------------+----------------------+

+-----------------------------------------------------------------------------------------+
| Processes: | |
| GPU | GI | CI | PID | Type | Process name | | GPU Memory |
| | ID | ID | Usage | |
|=========================================================================================|
| No running processes found | |
+-----------------------------------------------------------------------------------------+

!nvidia-smi

# - 1. Gather and Label Training Images

Before we start training, we need to gather and label images that will be used for training the object detection model. A good starting point for a proof-of-concept model is 200 images. The training images should have random objects in the image along with the desired objects, and should have a variety of backgrounds and lighting

conditions.

### There are a couple options for gathering images:

### Build a custom dataset by taking your own pictures of the objects and labeling them (this typically results in the best performance)

Find a pre-made dataset from sources like Robo%ow Universe, (https://colab.research.google.com/github/EdjeElectronics/Train-and-Deploy-YOLO-Models/blob/main/Train_YOLO_Models.ipynb) Kaggle, (https://colab.research.google.com/github/EdjeElectronics/Train-and-Deploy-YOLO-Models/blob/main/Train_YOLO_Models.ipynb) or Google Images V7 (https://colab.research.google.com/github/EdjeElectronics/Train-and-Deploy-YOLO-Models/blob/main/Train_YOLO_Models.ipynb)

### If you want to build your own dataset, there are several tools available for labeling

images. One good option is Label Studio, (https://labelstud.io/?utm_source=youtube&utm_medium=video&utm_campaign=edjeelectronics) a free and open-source labeling tool that

### has a simple work%ow while providing capabilities for more advanced features. My YouTube video that walks through this notebook (link to be added soon) shows how to

label images with Label Studio.

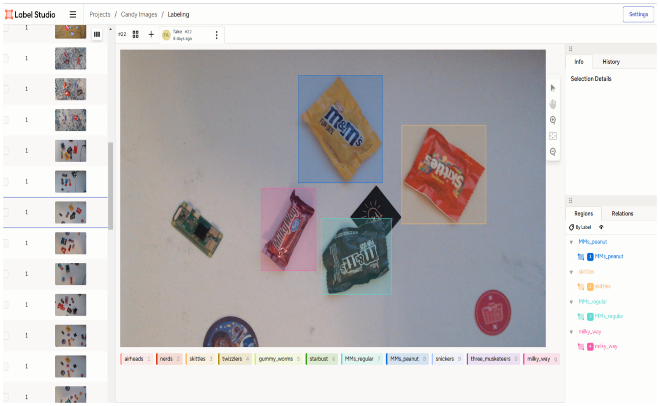
[picture p21: figure]

Example of a candy image labeled with Label Studio.

### If you used Label Studio to label and export the images, they'll be exported in a project.zip !le that contains the following:

### An images folder containing the images A labels folder containing the labels in YOLO annotation format A classes.txt labelmap !le that contains all the classes A notes.json !le that contains info speci!c to Label Studio (this !le can be ignored)

### If you obtained your dataset from another source (like Robo%ow Universe) or used another tool to label your dataset, make sure the !les are organized in the same

folder structure.

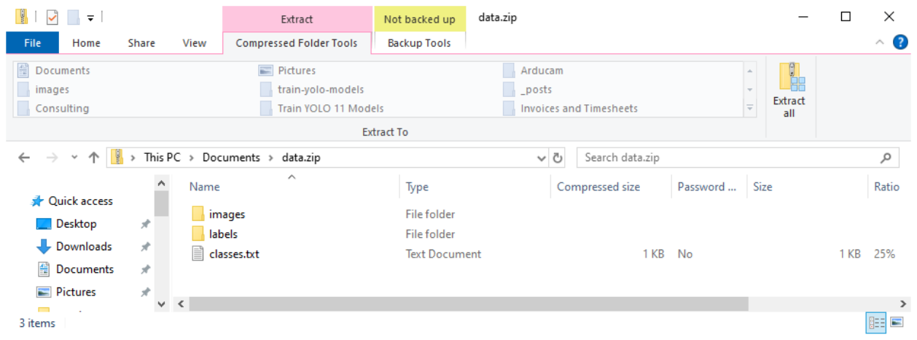
[picture p22: figure]
File; Home; 当Documents; images Consulting; Share; View; Extract; CompressedFolderTools; Pictures train-yolo-models TrainYOLO11Models; Notbackedup; data.zip; BackupTools; -Arducam; _posts; InvoicesandTimesheets; ExtractTo; Searchdata.zip; Compressedsize; Password...; *Quickaccess LDesktop Downloads; mDocuments; •Pictures; 3items; >ThisPC>Documents›data.zip; Name; images; labels #classes.txt; Type; Filefolder; TextDocument; = Extract all; Size; Ratio

Organize your data in the folders shown here. See my Candy Detection Dataset (https://s3.us-west-1.amazonaws.com/evanjuras.com/resources/candy_data_06JAN25.zip) for an example.

### Once you've got your dataset built, put into the !le structure shown above, and

zipped into data.zip , you're ready to move on to the next step.

# - 2. Upload Image Dataset and Prepare Training Data

### Next, we'll upload our dataset and prepare it for training with YOLO. We'll split the dataset into train and validation folders, and we'll automatically generate the

con!guration !le for training the model.

### First, we need to upload the dataset to Colab. Here are a few options for moving the

data.zip folder into this Colab instance.

# - 2.1 Upload images

### Option 1. Upload through Google Colab

### Upload the data.zip !le to the Google Colab instance by clicking the "Files" icon

on the le# hand side of the browser, and then the "Upload to session storage" icon. Select the zip folder to upload it.

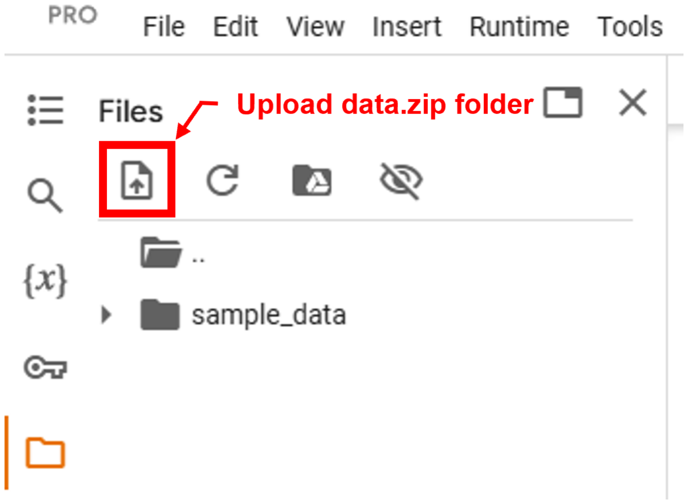
[picture p23: figure]
PRO; Files; FileEditViewInsertRuntimeTools; Uploaddata.zipfolder; sample_data

### Option 2. Copy from Google Drive

You can also upload your images to your personal Google Drive, mount the drive on this Colab session, and copy them over to the Colab !lesystem. This option works well if you want to upload the images beforehand so you don't have to wait for them to upload each time you restart this Colab. If you have more than 50MB worth of

images, I recommend using this option.

First, upload the data.zip !le to your Google Drive, and make note of the folder you uploaded them to. Replace MyDrive/path/to/data.zip with the path to your zip !le. (For example, I uploaded the zip !le to folder called "candy-dataset1", so I would use MyDrive/candy-dataset1/data.zip for the path). Then, run the following block of code to mount your Google Drive to this Colab session and copy

the folder to this !lesystem.

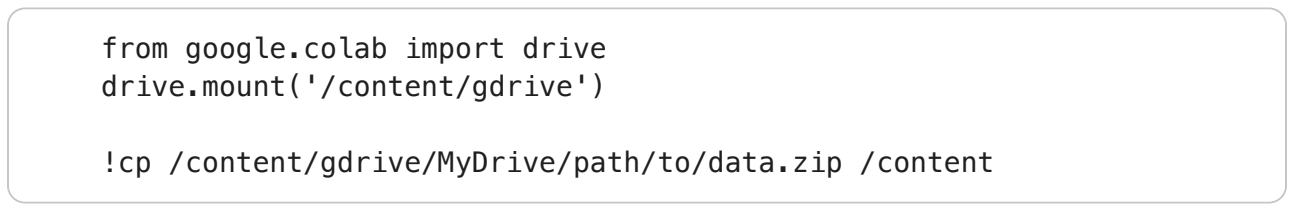
[picture p24: figure]
from google.colab import drive drive.mount('/content/gdrive'); !cp /content/gdrive/MyDrive/path/to/data.zip /content

### Option 3. Use my candy detection or coin detection dataset

### If you just want to test the process on a pre-made dataset, you can use one of my datasets:

Candy image dataset, (https://s3.us-west-1.amazonaws.com/evanjuras.com/resources/candy_data_14DEC24.zip) which contains 162 pictures of popular candies (Ski"les,

### Snickers, etc)

Coin image dataset, (https://s3.us-west-1.amazonaws.com/evanjuras.com/resources/YOLO_coin_data_12DEC30.zip) which contains 750 pictures of US coins (pennies, dimes,

### nickels, and quarters)

### Download one of the datasets by running the following code block. I'll use the candy

detection dataset as the example for the rest of the notebook.

--2026-07-07 21:17:47-- https://s3.us-west-1.amazonaws.com/evanjuras.com/resources/candy_data_06JAN25.zip Resolving s3.us-west-1.amazonaws.com (s3.us-west-1.amazonaws.com)... 16.15.4.140, 52.219.216.240, 52.219.192.64, ... Connecting to s3.us-west-1.amazonaws.com (s3.us-west-1.amazonaws.com)|16.15.4.140|:443... connected.
HTTP request sent, awaiting response... 200 OK
Length: 45172966 (43M) [application/zip]
Saving to: ‘/content/data.zip’
/content/data.zip | 100%[===================>] 43.08M 11.8MB/s | in 4.0s

2026-07-07 21:17:52 (10.8 MB/s) - ‘/content/data.zip’ saved [45172966/45172966]

# To use my one of pre-made dataset instead of your own custom dataset,

!wget -O /content/data.zip https://s3.us-west-1.amazonaws.com/evanjuras.com/resources/candy_data_0 #!wget -O /content/data.zip https://s3.us-west-1.amazonaws.com/evanjuras.com/resources/YOLO_coin_dat

# - 2.2 Split images into train and validation folders

### At this point, whether you used Option 1, 2, or 3, you should be able to click the folder icon on the le# and see your data.zip !le in the list of !les. Next, we'll unzip data.zip and create some folders to hold the images. Run the following code

block to unzip the data.

!wget -O /content/train_val_split.py https://raw.githubusercontent.com/EdjeElectronics/Train-and-Deploy-YOLO-Models/refs/heads/main/utils/train_val_split.py

Ultralytics requires a particular folder structure to store training data for models.

### Ultralytics requires a particular folder structure to store training data for models. The root folder is named “data”. Inside, there are two main folders:

### Train: These are the actual images used to train the model. In one epoch of training, every image in the train set is passed into the neural network. The

training algorithm adjusts the network weights to !t the data in the images.

### Validation: These images are used to check the model's performance at the

end of each training epoch.

### In each of these folders is a “images” folder and a “labels” folder, which hold the

image !les and annotation !les respectively.

### I wrote a Python script that will automatically create the required folder structure and

randomly move 90% of dataset to the "train" folder and 10% to the "validation" folder. Run the following code block to download and execute the scrpt.

--2026-07-07 21:22:54-- https://raw.githubusercontent.com/EdjeElectronics/Train-and-Deploy-YOLO-Models/refs/heads/main/utils/train_val_split.py Resolving raw.githubusercontent.com (raw.githubusercontent.com)... 185.199.108.133, 185.199.111.133, 185.199.110.133, ...
Connecting to raw.githubusercontent.com (raw.githubusercontent.com)|185.199.108.133|:443... connected.
HTTP request sent, awaiting response... 200 OK
Length: 3203 (3.1K) [text/plain]
Saving to: ‘/content/train_val_split.py’
/content/train_val_ 100%[===================>] | 3.13K --.-KB/s | in 0s

2026-07-07 21:22:54 (41.6 MB/s) - ‘/content/train_val_split.py’ saved [3203/3203]

Created folder at /content/data/train/images.
Created folder at /content/data/train/labels.
Created folder at /content/data/validation/images.
Created folder at /content/data/validation/labels. Number of image files: 633
Number of annotation files: 633
Images moving to train: 569
Images moving to validation: 64

!wget -O /content/train_val_split.py https://raw.githubusercontent.com/EdjeElectronics/

# TO DO: Improve robustness of train_val_split.py script so

!python train_val_split.py --datapath="/content/custom_data"

!pip install ultralytics

### Next, we'll install the Ultralytics library in this Google Colab instance. This Python

library will be used to train the YOLO model.

# - 3. Install Requirements (Ultralytics)

Requirement already satisfied: numpy>=1.23.0 in /usr/local/lib/python3.12/dist-packages (from ultralytics) (2.0.2)
Requirement already satisfied: matplotlib>=3.3.0 in /usr/local/lib/python3.12/dist-packages (from ultralytics) (3.10.0)
Requirement already satisfied: opencv-python!=4.13.0.90,>=4.6.0 in /usr/local/lib/python3.12/dist-packages (from ultralytics) (4.13.0.92) Requirement already satisfied: pillow>=7.1.2 in /usr/local/lib/python3.12/dist-packages (from ultralytics) (11.3.0)
Requirement already satisfied: pyyaml>=5.3.1 in /usr/local/lib/python3.12/dist-packages (from ultralytics) (6.0.3)
Requirement already satisfied: requests>=2.23.0 in /usr/local/lib/python3.12/dist-packages (from ultralytics) (2.32.4)
Requirement already satisfied: torch>=1.8.0 in /usr/local/lib/python3.12/dist-packages (from ultralytics) (2.11.0+cu128) Requirement already satisfied: torchvision>=0.9.0 in /usr/local/lib/python3.12/dist-packages (from ultralytics) (0.26.0+cu128) Requirement already satisfied: psutil>=5.8.0 in /usr/local/lib/python3.12/dist-packages (from ultralytics) (5.9.5) Requirement already satisfied: polars>=0.20.0 in /usr/local/lib/python3.12/dist-packages (from ultralytics) (1.35.2) Requirement already satisfied: nvidia-ml-py>=12.0.0 in /usr/local/lib/python3.12/dist-packages (from ultralytics) (13.610.43) Collecting ultralytics-thop>=2.0.18 (from ultralytics)
Downloading ultralytics_thop-2.0.20-py3-none-any.whl.metadata (14 kB)
Requirement already satisfied: contourpy>=1.0.1 in /usr/local/lib/python3.12/dist-packages (from matplotlib>=3.3.0->ultralytics) (1.3.3) Requirement already satisfied: cycler>=0.10 in /usr/local/lib/python3.12/dist-packages (from matplotlib>=3.3.0->ultralytics) (0.12.1) Requirement already satisfied: fonttools>=4.22.0 in /usr/local/lib/python3.12/dist-packages (from matplotlib>=3.3.0->ultralytics) (4.63.0) Requirement already satisfied: kiwisolver>=1.3.1 in /usr/local/lib/python3.12/dist-packages (from matplotlib>=3.3.0->ultralytics) (1.5.0) Requirement already satisfied: packaging>=20.0 in /usr/local/lib/python3.12/dist-packages (from matplotlib>=3.3.0->ultralytics) (26.2) Requirement already satisfied: pyparsing>=2.3.1 in /usr/local/lib/python3.12/dist-packages (from matplotlib>=3.3.0->ultralytics) (3.3.2) Requirement already satisfied: python-dateutil>=2.7 in /usr/local/lib/python3.12/dist-packages (from matplotlib>=3.3.0->ultralytics) (2.9.0.post0) Requirement already satisfied: polars-runtime-32==1.35.2 in /usr/local/lib/python3.12/dist-packages (from polars>=0.20.0->ultralytics) (1.35.2) Requirement already satisfied: charset_normalizer<4,>=2 in /usr/local/lib/python3.12/dist-packages (from requests>=2.23.0->ultralytics) (3.4.7) Requirement already satisfied: idna<4,>=2.5 in /usr/local/lib/python3.12/dist-packages (from requests>=2.23.0->ultralytics) (3.18)
Requirement already satisfied: urllib3<3,>=1.21.1 in /usr/local/lib/python3.12/dist-packages (from requests>=2.23.0->ultralytics) (2.5.0) Requirement already satisfied: certifi>=2017.4.17 in /usr/local/lib/python3.12/dist-packages (from requests>=2.23.0->ultralytics) (2026.6.17) Requirement already satisfied: filelock in /usr/local/lib/python3.12/dist-packages (from torch>=1.8.0->ultralytics) (3.29.4)
Requirement already satisfied: typing-extensions>=4.10.0 in /usr/local/lib/python3.12/dist-packages (from torch>=1.8.0->ultralytics) (4.15.0) Requirement already satisfied: setuptools<82 in /usr/local/lib/python3.12/dist-packages (from torch>=1.8.0->ultralytics) (75.2.0) Requirement already satisfied: sympy>=1.13.3 in /usr/local/lib/python3.12/dist-packages (from torch>=1.8.0->ultralytics) (1.14.0) Requirement already satisfied: networkx>=2.5.1 in /usr/local/lib/python3.12/dist-packages (from torch>=1.8.0->ultralytics) (3.6.1)
Requirement already satisfied: jinja2 in /usr/local/lib/python3.12/dist-packages (from torch>=1.8.0->ultralytics) (3.1.6)
Requirement already satisfied: fsspec>=0.8.5 in /usr/local/lib/python3.12/dist-packages (from torch>=1.8.0->ultralytics) (2025.3.0)
Requirement already satisfied: cuda-toolkit==12.8.1 in /usr/local/lib/python3.12/dist-packages (from cuda-toolkit[cublas,cudart,cufft,cufile,cupti,curand,cusolver,cusparse,nvjitlink,nvrtc,nvtx]==12.8.1; platform_system == "Linux"->torch>=1.8.0->ultralytics) (12.8.1) Requirement already satisfied: cuda-bindings<13,>=12.9.4 in /usr/local/lib/python3.12/dist-packages (from torch>=1.8.0->ultralytics) (12.9.7)
Requirement already satisfied: nvidia-cudnn-cu12==9.19.0.56 in /usr/local/lib/python3.12/dist-packages (from torch>=1.8.0->ultralytics) (9.19.0.56)
Requirement already satisfied: nvidia-cusparselt-cu12==0.7.1 in /usr/local/lib/python3.12/dist-packages (from torch>=1.8.0->ultralytics) (0.7.1)
Requirement already satisfied: nvidia-nccl-cu12==2.28.9 in /usr/local/lib/python3.12/dist-packages (from torch>=1.8.0->ultralytics) (2.28.9)
Requirement already satisfied: nvidia-nvshmem-cu12==3.4.5 in /usr/local/lib/python3.12/dist-packages (from torch>=1.8.0->ultralytics) (3.4.5)
Requirement already satisfied: triton==3.6.0 in /usr/local/lib/python3.12/dist-packages (from torch>=1.8.0->ultralytics) (3.6.0)
Requirement already satisfied: nvidia-cublas-cu12==12.8.4.1.* in /usr/local/lib/python3.12/dist-packages (from cuda-toolkit[cublas,cudart,cufft,cufile,cupti,curand,cusolver,cusparse,nvjitlink,nvrtc,nvtx]==12.8.1; platform_system == "Linux"->torch>=1.8.0->ultralytics) (12.8.4.1) Requirement already satisfied: nvidia-cuda-runtime-cu12==12.8.90.* in /usr/local/lib/python3.12/dist-packages (from cuda-toolkit[cublas,cudart,cufft,cufile,cupti,curand,cusolver,cusparse,nvjitlink,nvrtc,nvtx]==12.8.1; platform_system == "Linux"->torch>=1.8.0->ultralytics) (12.8.90) Requirement already satisfied: nvidia-cufft-cu12==11.3.3.83.* in /usr/local/lib/python3.12/dist-packages (from cuda-toolkit[cublas,cudart,cufft,cufile,cupti,curand,cusolver,cusparse,nvjitlink,nvrtc,nvtx]==12.8.1; platform_system == "Linux"->torch>=1.8.0->ultralytics) (11.3.3.83)

!pip install ultralytics

Requirement already satisfied: nvidia-cufile-cu12==1.13.1.3.* in /usr/local/lib/python3.12/dist-packages (from cuda-toolkit[cublas,cudart,cufft,cufile,cupti,curand,cusolver,cusparse,nvjitlink,nvrtc,nvtx]==12.8.1; platform_system == "Linux"->torch>=1.8.0->ultralytics) (1.13.1.3) Requirement already satisfied: nvidia-cuda-cupti-cu12==12.8.90.* in /usr/local/lib/python3.12/dist-packages (from cuda-toolkit[cublas,cudart,cufft,cufile,cupti,curand,cusolver,cusparse,nvjitlink,nvrtc,nvtx]==12.8.1; platform_system == "Linux"->torch>=1.8.0->ultralytics) (12.8.90) Requirement already satisfied: nvidia-curand-cu12==10.3.9.90.* in /usr/local/lib/python3.12/dist-packages (from cuda-toolkit[cublas,cudart,cufft,cufile,cupti,curand,cusolver,cusparse,nvjitlink,nvrtc,nvtx]==12.8.1; platform_system == "Linux"->torch>=1.8.0->ultralytics) (10.3.9.90) Requirement already satisfied: nvidia-cusolver-cu12==11.7.3.90.* in /usr/local/lib/python3.12/dist-packages (from cuda-toolkit[cublas,cudart,cufft,cufile,cupti,curand,cusolver,cusparse,nvjitlink,nvrtc,nvtx]==12.8.1; platform_system == "Linux"->torch>=1.8.0->ultralytics) (11.7.3.90) Requirement already satisfied: nvidia-cusparse-cu12==12.5.8.93.* in /usr/local/lib/python3.12/dist-packages (from cuda-toolkit[cublas,cudart,cufft,cufile,cupti,curand,cusolver,cusparse,nvjitlink,nvrtc,nvtx]==12.8.1; platform_system == "Linux"->torch>=1.8.0->ultralytics) (12.5.8.93) Requirement already satisfied: nvidia-nvjitlink-cu12==12.8.93.* in /usr/local/lib/python3.12/dist-packages (from cuda-toolkit[cublas,cudart,cufft,cufile,cupti,curand,cusolver,cusparse,nvjitlink,nvrtc,nvtx]==12.8.1; platform_system == "Linux"->torch>=1.8.0->ultralytics) (12.8.93) Requirement already satisfied: nvidia-cuda-nvrtc-cu12==12.8.93.* in /usr/local/lib/python3.12/dist-packages (from cuda-toolkit[cublas,cudart,cufft,cufile,cupti,curand,cusolver,cusparse,nvjitlink,nvrtc,nvtx]==12.8.1; platform_system == "Linux"->torch>=1.8.0->ultralytics) (12.8.93) Requirement already satisfied: nvidia-nvtx-cu12==12.8.90.* in /usr/local/lib/python3.12/dist-packages (from cuda-toolkit[cublas,cudart,cufft,cufile,cupti,curand,cusolver,cusparse,nvjitlink,nvrtc,nvtx]==12.8.1; platform_system == "Linux"->torch>=1.8.0->ultralytics) (12.8.90) Requirement already satisfied: cuda-pathfinder~=1.1 in /usr/local/lib/python3.12/dist-packages (from cuda-bindings<13,>=12.9.4->torch>=1.8.0->ultralytics) (1.5.5)
Requirement already satisfied: six>=1.5 in /usr/local/lib/python3.12/dist-packages (from python-dateutil>=2.7->matplotlib>=3.3.0->ultralytics) (1.17.0)
Requirement already satisfied: mpmath<1.4,>=1.1.0 in /usr/local/lib/python3.12/dist-packages (from sympy>=1.13.3->torch>=1.8.0->ultralytics) (1.3.0)
Requirement already satisfied: MarkupSafe>=2.0 in /usr/local/lib/python3.12/dist-packages (from jinja2->torch>=1.8.0->ultralytics) (3.0.3)
Downloading ultralytics-8.4.90-py3-none-any.whl (1.3 MB)
━━━━━━━━━━━━━━━━━━━━━━━━━━━━━━━━━━━━━━━━ 1.3/1.3 MB 35.6 MB/s eta
Downloading ultralytics_thop-2.0.20-py3-none-any.whl (28 kB)
Installing collected packages: ultralytics-thop, ultralytics

# - 4. Con!gure Training

### There's one last step before we can run training: we need to create the Ultralytics training con!guration YAML !le. This !le speci!es the location of your train and validation data, and it also de!nes the model's classes. An example con!guration !le

model is available here. (https://github.com/ultralytics/ultralytics/blob/main/ultralytics/cfg/datasets/coco128.yaml)
Run the code block below to automatically generate a data.yaml con!guration !le.

### Make sure you have a labelmap !le located at custom_data/classes.txt . If you used Label Studio or one of my pre-made datasets, it should already be present. If you assembled the dataset another way, you may have to manually create the

classes.txt !le (see here (https://github.com/EdjeElectronics/Train-and-Deploy-YOLO-Models/blob/main/doc/classes.txt) for an example of how it's forma"ed).

# Python function to automatically create data.yaml config file

# 1. Reads "classes.txt" file to get list of class names

# 2. Creates data dictionary with correct paths to folders, number of # 3. Writes data in YAML format to data.yaml

import yaml
import os

def create_data_yaml(path_to_classes_txt, path_to_data_yaml):

# Read class.txt to get class names

if not os.path.exists(path_to_classes_txt):
print(f'classes.txt file not found! Please create a classes.txt labelmap return

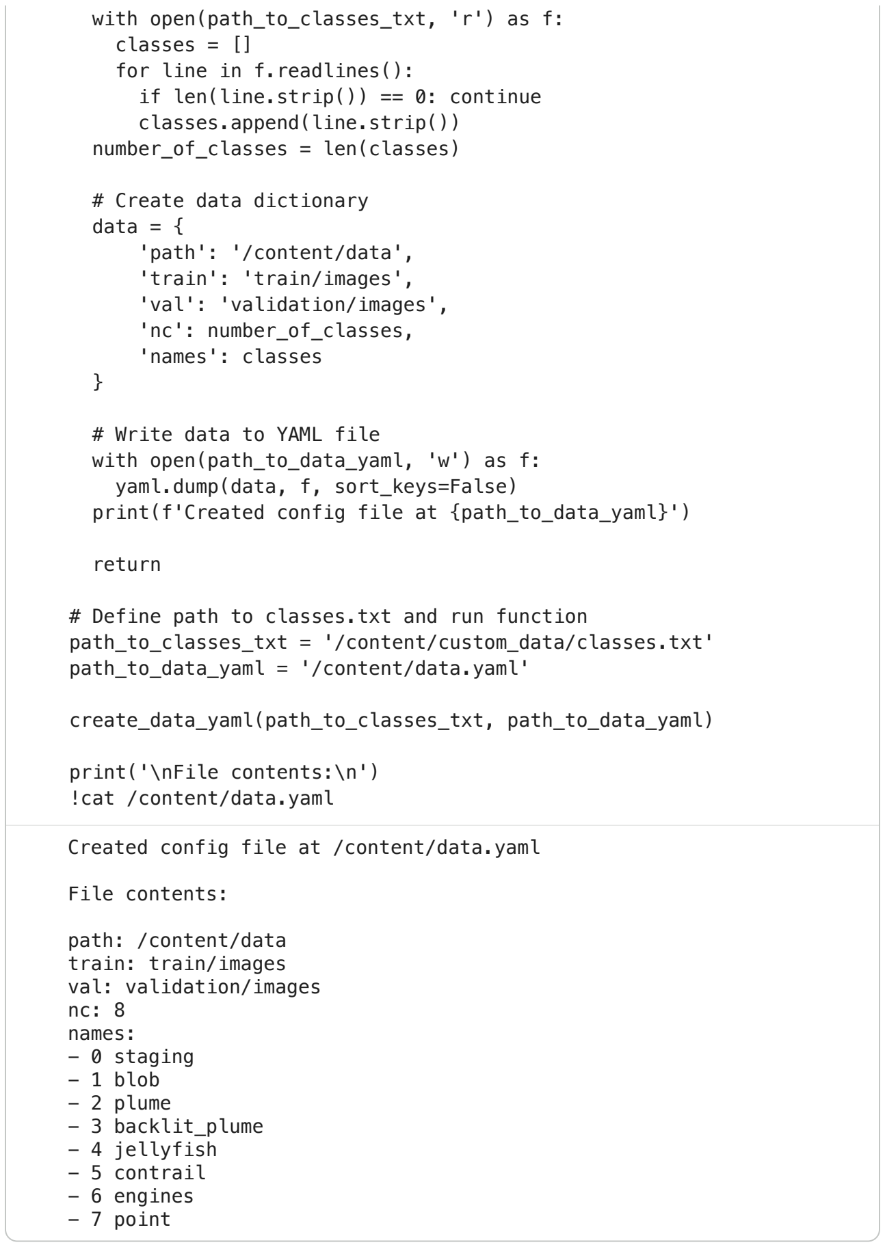
[picture p25: figure]
Created config file at /content/data.yaml; File contents:; path: /content/data train: train/images val: validation/images nc: 8 names: - 0 staging - 1 blob - 2 plume - 3 backlit_plume - 4 jellyfish - 5 contrail - 6 engines - 7 point; with open(path_to_classes_txt, 'r') as f: classes = [] for line in f.readlines(): if len(line.strip()) == 0: continue classes.append(line.strip()) number_of_classes = len(classes); # Create data dictionary data = { 'path': '/content/data', 'train': 'train/images', 'val': 'validation/images', 'nc': number_of_classes, 'names': classes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

# Define path to classes.txt and run function

# - 5. Train Model

### Now that the data is organized and the con!g !le is created, we're ready to start training! First, there are a few important parameters to decide on. Visit my article on

Training YOLO Models Locally (https://www.ejtech.io/learn/train-yolo-models) to learn more about these parameters and how to choose them.

### Model architecture & size ( model ):

There are several YOLO11 models sizes available to train, including yolo11n.pt , yolo11s.pt , yolo11m.pt , yolo11l.pt , and yolo11xl.pt . Larger models

### run slower but have higher accuracy, while smaller models run faster but have lower accuracy. I made a brief YouTube video that compares performance of di&erent YOLO models on a Raspberry Pi 5 and a laptop with a RTX 4050 GPU, check it out here to

get a sense of their speed accuracy. If you aren't sure which model size to use, (https://youtu.be/_WKS4E9SmkA) yolo11s.pt is a good starting point.

### You can also train YOLOv8 or YOLOv5 models by substituting yolo11 for yolov8

or yolov5 .

### Number of epochs ( epochs )

In machine learning, one “epoch” is one single pass through the full training dataset.

Se"ing the number of epochs dictates how long the model will train for. The best amount of epochs to use depends on the size of the dataset and the model architecture. If your dataset has less than 200 images, a good starting point is 60 epochs. If your dataset has more than 200 images, a good starting point is 40

epochs.

### Resolution ( imgsz )

Resolution has a large impact on the speed and accuracy of the model: a lower resolution model will have higher speed but less accuracy. YOLO models are typically trained and inferenced at a 640x640 resolution. However, if you want your model to run faster or know you will be working with low-resolution images, try using a lower

resolution like 480x480.

# 5.1 Training Parameters

!yolo detect train data=/content/data.yaml model=yolo11s.pt epochs=60 imgsz=640

# - 5.2 Run Training!

Run the following code block to begin training. If you want to use a di&erent model,
number of epochs, or resolution, change model , epochs , or imgsz .
Epoch | GPU_mem | box_loss | cls_loss | dfl_loss Instances | Size
52/60 | 4.35G | 1.25 | 0.6927 | 1.185 | 9 | 640: 100%
Class | Images Instances | Box(P | R | mAP50 mAP50-95): 100%
all | 64 | 64 | 0.934 | 0.944 | 0.98 | 0.618
Epoch | GPU_mem | box_loss | cls_loss | dfl_loss Instances | Size
53/60 | 4.35G | 1.185 | 0.6846 | 1.158 | 9 | 640: 100%
Class | Images Instances | Box(P | R | mAP50 mAP50-95): 100%
all | 64 | 64 | 0.924 | 0.953 | 0.979 | 0.601
Epoch | GPU_mem | box_loss | cls_loss | dfl_loss Instances | Size
54/60 | 4.35G | 1.177 | 0.6553 | 1.157 | 9 | 640: 100%
Class | Images Instances | Box(P | R | mAP50 mAP50-95): 100%
all | 64 | 64 | 0.928 | 0.951 | 0.98 | 0.638
Epoch | GPU_mem | box_loss | cls_loss | dfl_loss Instances | Size
55/60 | 4.35G | 1.188 | 0.6656 | 1.145 | 9 | 640: 100%
Class | Images Instances | Box(P | R | mAP50 mAP50-95): 100%
all | 64 | 64 | 0.936 | 0.934 | 0.979 | 0.605
Epoch | GPU_mem | box_loss | cls_loss | dfl_loss Instances | Size
56/60 | 4.35G | 1.176 | 0.6506 | 1.157 | 9 | 640: 100%
Class | Images Instances | Box(P | R | mAP50 mAP50-95): 100%
all | 64 | 64 | 0.898 | 0.946 | 0.978 | 0.622
Epoch | GPU_mem | box_loss | cls_loss | dfl_loss Instances | Size
57/60 | 4.35G | 1.175 | 0.6407 | 1.15 | 9 | 640: 100%
Class | Images Instances | Box(P | R | mAP50 mAP50-95): 100%
all | 64 | 64 | 0.93 | 0.954 | 0.981 | 0.616
Epoch | GPU_mem | box_loss | cls_loss | dfl_loss Instances | Size
58/60 | 4.35G | 1.172 | 0.6374 | 1.144 | 9 | 640: 100%
Class | Images Instances | Box(P | R | mAP50 mAP50-95): 100%
all | 64 | 64 | 0.935 | 0.969 | 0.981 | 0.625
Epoch | GPU_mem | box_loss | cls_loss | dfl_loss Instances | Size
59/60 | 4.35G | 1.174 | 0.6405 | 1.151 | 9 | 640: 100%
Class | Images Instances | Box(P | R | mAP50 mAP50-95): 100%
all | 64 | 64 | 0.937 | 0.958 | 0.981 | 0.619
Epoch | GPU_mem | box_loss | cls_loss | dfl_loss Instances | Size
60/60 | 4.35G | 1.159 | 0.6235 | 1.141 | 9 | 640: 100%

!yolo detect train data=/content/data.yaml model=yolo11s.pt

!yolo detect predict model=runs/detect/train/weights/best.pt source=data/validation/images save=True

Class | Images Instances | Box(P | R | mAP50 mAP50-95): 100%
all | 64 | 64 | 0.933 | 0.953 | 0.98 | 0.62

60 epochs completed in 0.269 hours.
Optimizer stripped from /content/runs/detect/train/weights/last.pt, 19.2MB Optimizer stripped from /content/runs/detect/train/weights/best.pt, 19.2MB

Validating /content/runs/detect/train/weights/best.pt...
Ultralytics 8.4.90 Python-3.12.13 torch-2.11.0+cu128 CUDA:0 (Tesla T4, 14913MiB) YOLO11s summary (fused): 101 layers, 9,415,896 parameters, 0 gradients, 21.3 GFLOPs
Class | Images Instances | Box(P | R | mAP50 mAP50-95): 100%
all | 64 | 64 | 0.919 | 0.967 | 0.981 | 0.641
0 staging | 4 | 4 | 0.903 | 1 | 0.995 | 0.615
1 blob | 9 | 9 | 0.838 | 0.889 | 0.885 | 0.551
2 plume | 13 | 13 | 1 | 0.987 | 0.995 | 0.621
3 backlit_plume | 11 | 11 | 0.962 | 1 | 0.995 | 0.59

### The training algorithm will parse the images in the training and validation directories and then start training the model. At the end of each training epoch, the program runs the model on the validation dataset and reports the resulting mAP, precision, and

recall. As training continues, the mAP should generally increase with each epoch. Training will end once it goes through the number of epochs speci!ed by epochs .

### NOTE: Make sure to allow training to run to completion, because an optimizer runs at the end of training that strips out unneeded layers

from the model.

### The best trained model weights will be saved in

### training is saved in the content/runs/detect/train folder, including a results.png !le that shows how loss, precision, recall, and mAP progressed over

each epoch.

# - 6. Test Model

### The model has been trained; now it's time to test it! The commands below run the model on the images in the validation folder and then display the results for the !rst 10 images. This is a good way to con!rm your model is working as expected. Click

Play on the blocks below to see how your model performs.

image 8/64 /content/data/validation/images/img15.jpg: 384x640 1 0 staging, 12.6ms image 9/64 /content/data/validation/images/img16.jpg: 384x640 1 0 staging, 14.2ms
image 10/64 /content/data/validation/images/img160.jpg: 384x640 3 4 jellyfishs, 14.2ms image 11/64 /content/data/validation/images/img171.jpg: 384x640 1 4 jellyfish, 11.5ms image 12/64 /content/data/validation/images/img181.jpg: 384x640 1 3 backlit_plume, 11.8ms image 13/64 /content/data/validation/images/img184.jpg: 384x640 2 3 backlit_plumes, 11.8ms image 14/64 /content/data/validation/images/img193.jpg: 384x640 2 3 backlit_plumes, 16.7ms image 15/64 /content/data/validation/images/img203.jpg: 384x640 1 3 backlit_plume, 13.5ms image 16/64 /content/data/validation/images/img210.jpg: 384x640 2 3 backlit_plumes, 16.9ms image 17/64 /content/data/validation/images/img221.jpg: 384x640 2 3 backlit_plumes, 15.5ms image 18/64 /content/data/validation/images/img232.jpg: 384x640 1 5 contrail, 12.2ms image 19/64 /content/data/validation/images/img237.jpg: 384x640 1 5 contrail, 12.1ms image 20/64 /content/data/validation/images/img264.jpg: 384x640 1 6 engines, 14.2ms
image 21/64 /content/data/validation/images/img267.jpg: 384x640 1 6 engines, 11.9ms image 22/64 /content/data/validation/images/img27.jpg: 384x640 1 0 staging, 11.7ms image 23/64 /content/data/validation/images/img270.jpg: 384x640 1 6 engines, 11.8ms image 24/64 /content/data/validation/images/img27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
image 63/64 /content/data/validation/images/img83.jpg: 384x640 1 1 blob, 9.9ms
image 64/64 /content/data/validation/images/img95.jpg: 384x640 1 2 plume, 9.8ms
Speed: 2.6ms preprocess, 13.8ms inference, 2.1ms postprocess per image at shape (1, 3, 384, 640)

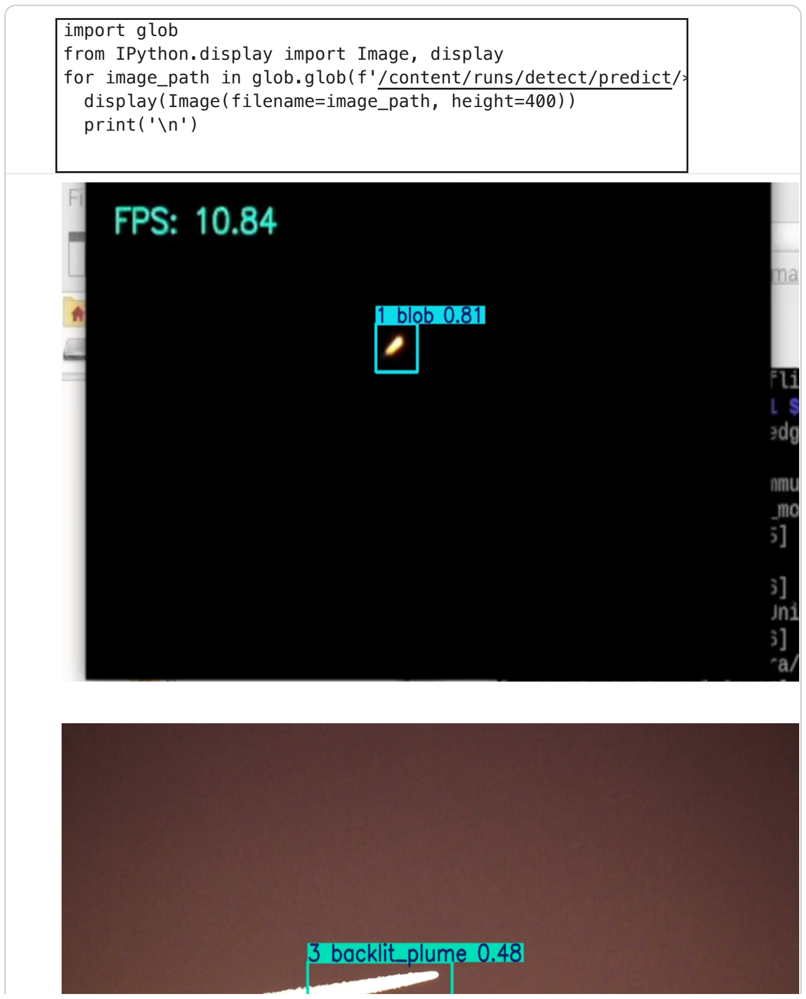
[picture p26: figure]
import glob; import glob from IPython.display import Image, display for image_path in glob.glob(f'/content/runs/detect/predict/*.jpg' display(Image(filename=image_path, height=400)) print('\n')
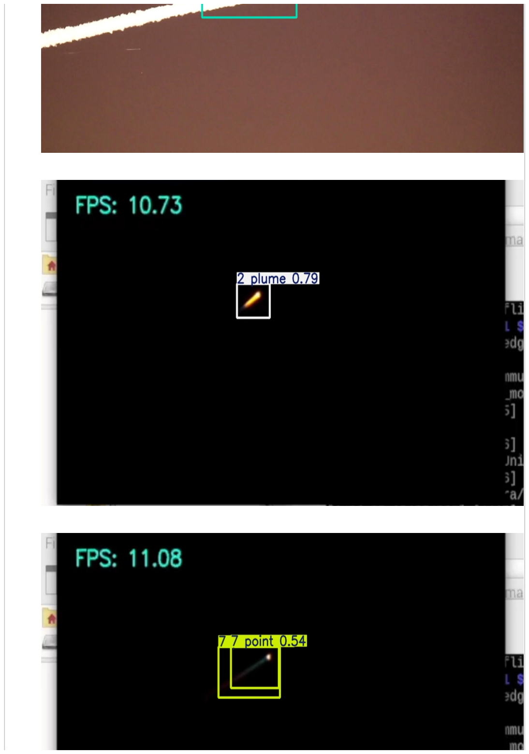
[picture p27: page 17]
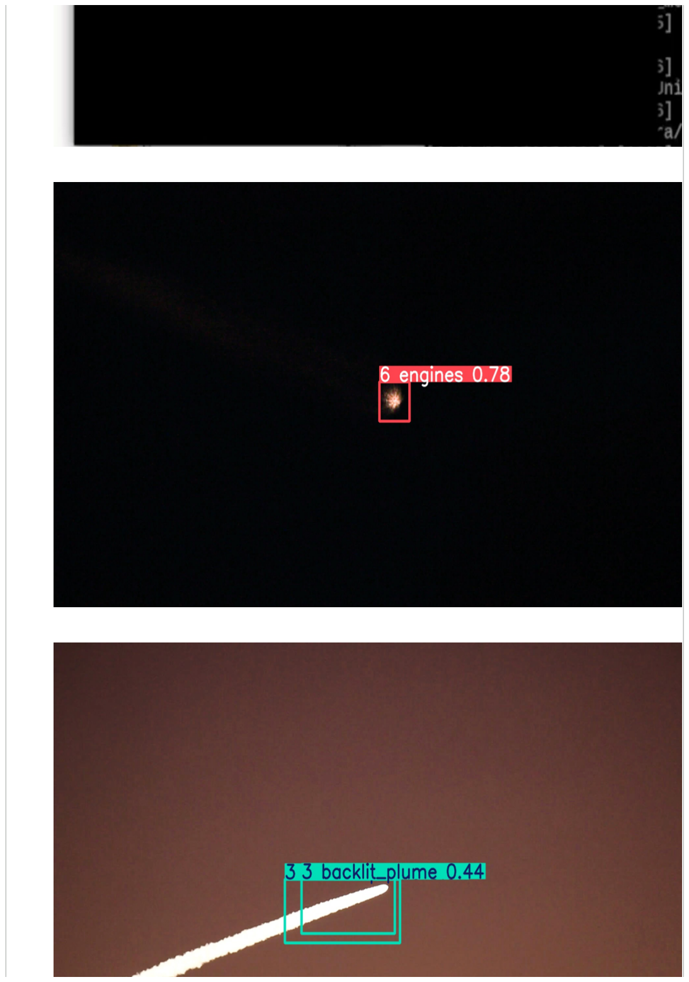
[picture p28: page 18]
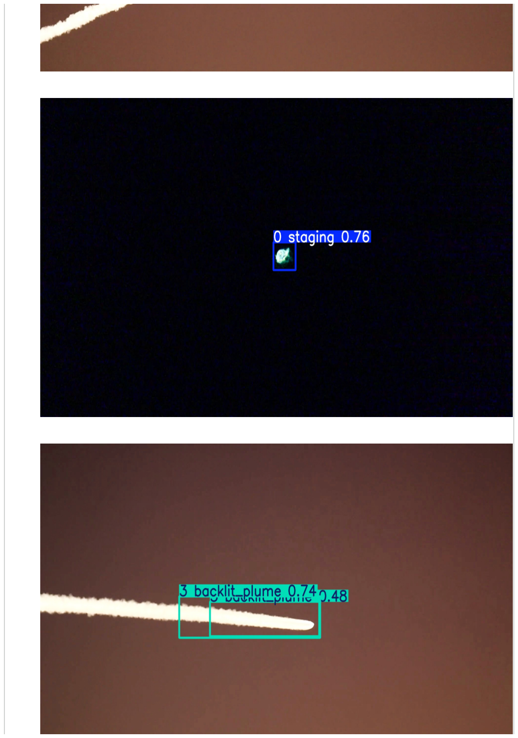
[picture p29: page 19]

# FPS:10.95

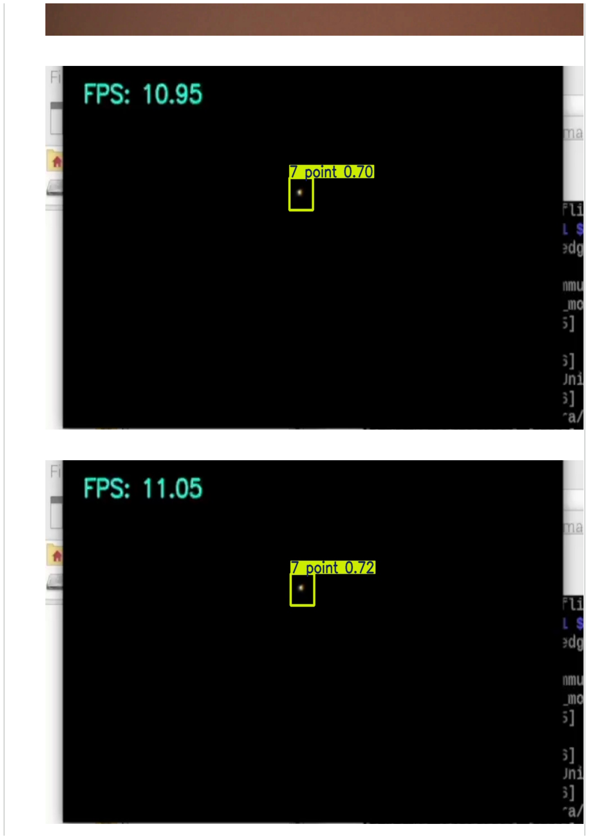
[picture p30: page 20]

### point0.70

ma

### Fli

LS

nmu
3］

3］
Jni
3]
*a/

# FPS:11.05

### point0.72

ma

### Fli

LS

## edg

nmu
3］

3]
Jni
3]
*a/

### The model should draw a box around each object of interest in each image. If it isn't doing a good job of detecting objects, here are a few tips:

### 1. Double-check your dataset to make sure there are no labeling errors or

con%icting examples.
2. Increase the number of epochs used for training.
3. Use a larger model size (e.g. yolo11l.pt ).
4. Add more images to the training dataset. See my dataset video (https://www.youtube.com/watch?v=v0ssiOY6cfg) for tips on how to capture good training images and improve accuracy.

### You can also run the model on video !les or other images images by uploading them to this notebook and using the above !yolo detect predict command, where source points to the location of the video !le, image, or folder of images. The

results will be saved in runs/detect/predict .

### Drawing boxes on images is great, but it isn't very useful in itself. It's also not very

helpful to just run this models inside a Colab notebook: it's easier if we can just run it

### on a local computer. Continue to the next section to see how to download your newly

trained model and run it on a local device.

# - 7. Deploy Model

### Now that your custom model has been trained, it's ready to be downloaded and

deployed in an application! YOLO models can run on a wide variety of hardware,

### including PCs, embedded systems, and phones. Ultralytics makes it easy to convert the YOLO models to various formats ( tflite , onnx , etc.) and deploy them in a

variety of environments.

### This section shows how to download the model and provides links to instructions for

deploying it on your PC and edge devices like the Raspberry Pi.

First, zip and download the trained model by running the code blocks below.

### The code creates a folder named my_model , moves the model weights into it, and renames them from best.pt to my_model.pt . It also adds the training results in

case you want to reference them later. It then zips the folder as my_model.zip .

# - 7.1 Download YOLO Model

/content/my_model
adding: my_model.pt (deflated 8%)
adding: train/ (stored 0%)
adding: train/weights/ (stored 0%)
adding: train/weights/best.pt (deflated 8%) adding: train/weights/last.pt (deflated 8%) adding: train/train_batch1800.jpg (deflated 44%) adding: train/train_batch2.jpg (deflated 26%) adding: train/BoxPR_curve.png (deflated 21%) adding: train/train_batch0.jpg (deflated 30%) adding: train/train_batch1801.jpg (deflated 48%) adding: train/train_batch1802.jpg (deflated 38%) adding: train/val_batch0_labels.jpg (deflated 20%) adding: train/val_batch1_labels.jpg (deflated 41%) adding: train/train_batch1.jpg (deflated 38%) adding: train/BoxF1_curve.png (deflated 6%)
adding: train/labels.jpg (deflated 38%)
adding: train/BoxP_curve.png (deflated 9%)
adding: train/confusion_matrix_normalized.png (deflated 22%) adding: train/args.yaml (deflated 53%)
adding: train/val_batch1_pred.jpg (deflated 40%)
adding: train/results.csv (deflated 62%)
adding: train/BoxR_curve.png (deflated 9%) adding: train/val_batch0_pred.jpg (deflated 19%) adding: train/confusion_matrix.png (deflated 25%) adding: train/results.png (deflated 7%)
/content

# Create "my_model" folder to store model weights and train results

!mkdir /content/my_model
!cp /content/runs/detect/train/weights/best.pt /content/my_model/my_model.pt !cp -r /content/runs/detect/train /content/my_model

# Zip into "my_model.zip"

%cd my_model
!zip /content/my_model.zip my_model.pt
!zip -r /content/my_model.zip train %cd /content

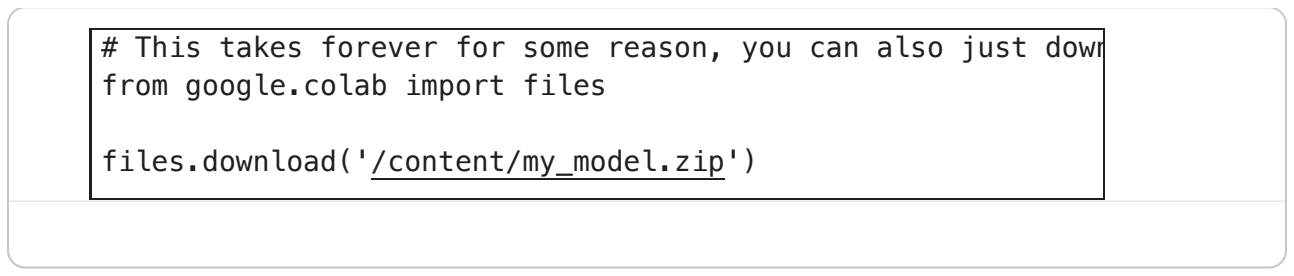
[picture p31: figure]
from google.colab import files; files.download('/content/my_model.zip')

# This takes forever for some reason, you can also just download the model from the sidebar # This takes forever for some reason, you can also just download

### Next, we'll take our downloaded model and run it on a local device. This section

provides instructions showing how to deploy YOLO models on various devices.
I wrote a basic Python script, yolo_detect.py , that shows how to load a model,

### run inference on an image source, parse the inference results, and display boxes

around each detected class in the image. The script (https://github.com/EdjeElectronics/Train-and-Deploy-YOLO-Models/blob/main/yolo_detect.py) gives an example of how to work

### with Ultralytics YOLO models in Python, and it can be used as a starting point for

more advanced applications.

# - 7.2 Deploy YOLO Model on Local Devices

### The easiest way to run Ultralytics models on a PC is using Anaconda. Anaconda sets up a virtual Python environment and allows you to easily install Ultralytics and PyTorch. It automatically installs CUDA and cuDNN, which allows you to speed up

model inference with your NVIDIA GPU.

### NOTE: My YouTube video (link to be added) shows how to deploy your model on a PC. It walks through the following steps, so watch the video

if you prefer having visual instructions.

### 1. Download and Install Anaconda

### Go to the Anaconda download page at h"ps://anaconda.com/download, click the “skip registration” bu"on, and then download the package for your OS. When it's !nished downloading, run the installer and click through the installation steps. You

can use the default options for installation.

### 2. Set up virtual environment

### Once it's installed, run Anaconda Prompt from the Start Bar. (If you're on macOS or

Linux, just open a command terminal).

## 7.2.1 Deploy on PC (Windows, Linux, or macOS)

### Issue the following commands to create a new Python environment and activate it:

conda create --name yolo-env1 python=3.12 -y

### Install Ultralytics (which also installs import libraries like OpenCV-Python, Numpy, and PyTorch) by issuing the following command:

pip install ultralytics

### If you have an NVIDIA GPU, you can install the GPU-enabled version of PyTorch by issuing the following command:

### 3. Extract downloaded model Take the my_model.zip !le you downloaded in Step 7.1 and unzip it to a folder on your PC. In the Anaconda Prompt terminal, move into the unzipped folder using:

cd path/to/folder

### 4. Download and run yolo_detect.py

### Download the yolo_detect.py script into the my_model folder using:

### Alright! We're ready to run the script. To run inference with a yolov8s model on a USB camera at 1280x720 resolution, issue:

### A window will appear showing a live feed from your webcam with boxes drawn around

detected objects in each frame.

### You can also run the model on an video !le, image, or folder of images. To see a full

list of arguments for yolo_detect.py , issue | python yolo_detect.py --
help | or see the README !le. (https://github.com/EdjeElectronics/Train-and-Deploy-YOLO-Models/blob/main/README.md)

pip install --upgrade torch torchvision torchaudio --index-url https://download.pytorch.org/whl/cu12

python yolo_detect.py --model my_model.pt --source usb0 --resolution 1280x720

### Keep an eye out for an article showing how to convert YOLO models to NCNN format and run them on the Raspberry Pi!

## 7.2.2 Deploy on Raspberry Pi

# - 8. Conclusion

### Congratulations! You've successfully trained and deployed a YOLO object detection

model.

Next, you can extend your application beyond just drawing boxes and counting objects. Add functionality like logging the number of objects detected over time or taking a picture when certain objects are detected. Check out some example applications at our GitHub repository: h"ps://github.com/EdjeElectronics/Train-and-Deploy-YOLO-Models (https://github.com/EdjeElectronics/Train-and-Deploy-YOLO-Models)

### Thanks for working through this notebook, and good luck with your projects!

# - Appendix: Common Errors

### If you run into any errors working through this notebook, please do the following:

### Double-check that the dataset !les are set up in the correct folder structure Make sure there are no typos or errors in your labelmap !le Google search the error to look for solutions

If none of those help, please submit an Issue (https://github.com/EdjeElectronics/Train-and-Deploy-YOLO-Models/issues) on the GitHub page. In this section, I will add resolutions to common errors as they come up.
