JohnRSmith101/rocket-tracker/models/mediapipe-dec2024/training-records/model_build_performance_by_epoch.xlsx

jsonrocket8 model build by epoch
Epoch | total_loss | val_total_loss
1 | 8.12 | 1.69
2 | 1.33 | 1.36
3 | 0.94 | 1.23
4 | 0.76 | 1.09
5 | 0.71 | 0.99
6 | 0.61 | 0.98
7 | 0.59 | 0.96
8 | 0.52 | 0.95
9 | 0.50 | 0.83
10 | 0.41 | 0.86
11 | 0.41 | 0.83
12 | 0.43 | 0.81
13 | 0.41 | 0.81
14 | 0.37 | 0.89
15 | 0.32 | 0.93
16 | 0.31 | 0.88
17 | 0.31 | 0.86
18 | 0.35 | 0.93
19 | 0.33 | 0.87
20 | 0.32 | 0.92
21 | 0.27 | 0.78
22 | 0.31 | 0.83
23 | 0.26 | 0.86
24 | 0.30 | 0.81
25 | 0.26 | 0.84
26 | 0.32 | 0.9
27 | 0.30 | 0.87
28 | 0.25 | 0.84
29 | 0.20 | 0.8
30 | 0.22 | 0.81
