JohnRSmith101/rocket-tracker/hardware/3d-printing/5mm_Bearing_Bushings_for_Long_EL_Shaft/preview.png

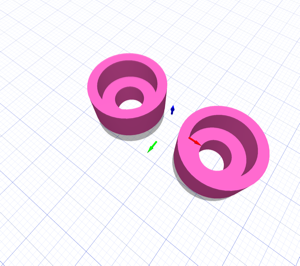
hardware/3d-printing/5mm_Bearing_Bushings_for_Long_EL_Shaft/preview.png
