JohnRSmith101/rocket-tracker/hardware/3d-printing/40_1_AZ_Worm_Gear_Frame/preview.png

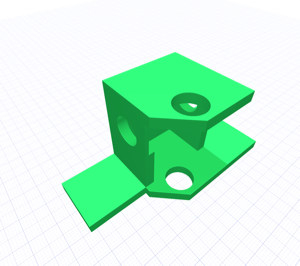
hardware/3d-printing/40_1_AZ_Worm_Gear_Frame/preview.png
