JohnRSmith101/rocket-tracker/hardware/3d-printing/60_1_EL_Worm_Gear_Frame/preview.png

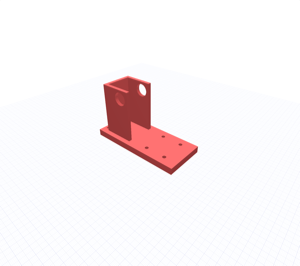
hardware/3d-printing/60_1_EL_Worm_Gear_Frame/preview.png
