JohnRSmith101/rocket-tracker/hardware/3d-printing/AZ_Spur_Gear_Mount/preview.png

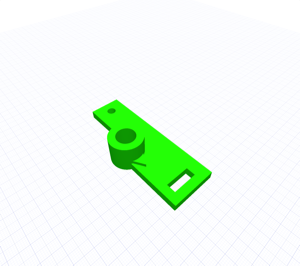
hardware/3d-printing/AZ_Spur_Gear_Mount/preview.png
