JohnRSmith101/rocket-tracker/hardware/3d-printing/Celestron_Arm_to_Flat_Plate/preview.png

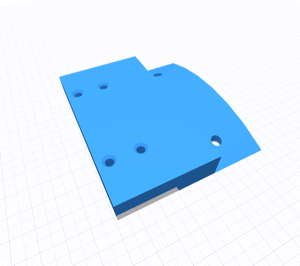
hardware/3d-printing/Celestron_Arm_to_Flat_Plate/preview.png
