JohnRSmith101/rocket-tracker/hardware/3d-printing/Large_GT2_Pulley_for_Celestron/preview.png

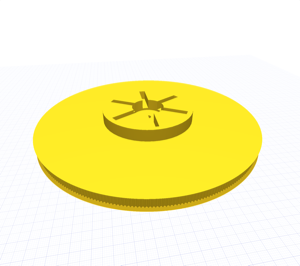
hardware/3d-printing/Large_GT2_Pulley_for_Celestron/preview.png
