JohnRSmith101/rocket-tracker/models/yolo/training-runs/yolo11n_60epochs/results.csv

epoch | time | train/box_loss | train/cls_loss | train/dfl_loss | metrics/precision(B) | metrics/recall(B) | metrics/mAP50(B) | metrics/mAP50-95(B) | val/box_loss | val/cls_loss | val/dfl_loss | lr/pg0 | lr/pg1 | lr/pg2
1 | 38.3183 | 2.10328 | 4.96976 | 1.4922 | 0.00453 | 0.81693 | 0.1794 | 0.04901 | 1.6056 | 4.94308 | 1.13953 | 0.000269954 | 0.000269954 | 0.000269954
2 | 51.2441 | 1.85468 | 3.62389 | 1.35383 | 0.00368 | 0.97078 | 0.261 | 0.11949 | 1.61504 | 4.54594 | 1.13853 | 0.000538585 | 0.000538585 | 0.000538585
3 | 65.075 | 1.77163 | 2.99641 | 1.34015 | 1 | 0.0636 | 0.3942 | 0.1844 | 1.56517 | 3.99653 | 1.29065 | 0.000798053 | 0.000798053 | 0.000798053
4 | 78.7431 | 1.6963 | 2.69207 | 1.36033 | 0.63136 | 0.62432 | 0.73877 | 0.3717 | 1.60571 | 2.89347 | 1.3206 | 0.000791767 | 0.000791767 | 0.000791767
5 | 92.2332 | 1.63836 | 2.41256 | 1.32957 | 0.542 | 0.88848 | 0.78311 | 0.35813 | 1.60762 | 2.52227 | 1.34984 | 0.000778022 | 0.000778022 | 0.000778022
6 | 105.927 | 1.66255 | 2.18839 | 1.3303 | 0.61766 | 0.7349 | 0.81123 | 0.37721 | 1.70236 | 2.27588 | 1.38989 | 0.000764278 | 0.000764278 | 0.000764278
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
