JohnRSmith101/rocket-tracker/models/yolo/training-runs/yolo11n_90epochs_DEPLOYED/results.csv

epoch | time | train/box_loss | train/cls_loss | train/dfl_loss | metrics/precision(B) | metrics/recall(B) | metrics/mAP50(B) | metrics/mAP50-95(B) | val/box_loss | val/cls_loss | val/dfl_loss | lr/pg0 | lr/pg1 | lr/pg2
1 | 37.452 | 2.10114 | 5.01053 | 1.48544 | 0.00258 | 0.62723 | 0.09636 | 0.03132 | 1.72657 | 5.09335 | 1.242 | 0.000269954 | 0.000269954 | 0.000269954
2 | 50.4579 | 1.86818 | 3.63349 | 1.38771 | 0.00192 | 0.51897 | 0.14985 | 0.0714 | 1.66408 | 4.85873 | 1.41359 | 0.000541597 | 0.000541597 | 0.000541597
3 | 63.6833 | 1.7542 | 2.9425 | 1.38006 | 0.65057 | 0.14393 | 0.46508 | 0.22763 | 1.59268 | 3.7667 | 1.31477 | 0.000807131 | 0.000807131 | 0.000807131
4 | 77.7044 | 1.7027 | 2.63253 | 1.38786 | 0.48765 | 0.48754 | 0.56276 | 0.27742 | 1.86511 | 3.07682 | 1.47398 | 0.000805511 | 0.000805511 | 0.000805511
5 | 90.6086 | 1.63388 | 2.36035 | 1.30124 | 0.54611 | 0.79656 | 0.77979 | 0.33961 | 1.84025 | 2.72518 | 1.49899 | 0.000796348 | 0.000796348 | 0.000796348
6 | 104.272 | 1.60042 | 2.11754 | 1.30987 | 0.60167 | 0.8274 | 0.83619 | 0.36259 | 1.72812 | 2.40003 | 1.40017 | 0.000787185 | 0.000787185 | 0.000787185
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
