JohnRSmith101/rocket-tracker/models/yolo/training-runs/yolo11s_60epochs/results.csv

epoch | time | train/box_loss | train/cls_loss | train/dfl_loss | metrics/precision(B) | metrics/recall(B) | metrics/mAP50(B) | metrics/mAP50-95(B) | val/box_loss | val/cls_loss | val/dfl_loss | lr/pg0 | lr/pg1 | lr/pg2
1 | 41.9537 | 2.12212 | 6.41937 | 1.48753 | 0.56011 | 0.55442 | 0.47628 | 0.22764 | 1.80774 | 4.80594 | 1.43171 | 0.000269954 | 0.000269954 | 0.000269954
2 | 56.7269 | 1.75467 | 2.71221 | 1.33243 | 0.65651 | 0.44012 | 0.5092 | 0.26285 | 1.83876 | 3.0829 | 1.46226 | 0.000538585 | 0.000538585 | 0.000538585
3 | 72.4105 | 1.72845 | 1.92556 | 1.35096 | 0.51196 | 0.58357 | 0.70276 | 0.3557 | 1.58972 | 2.08027 | 1.39685 | 0.000798053 | 0.000798053 | 0.000798053
4 | 88.1234 | 1.66269 | 1.57653 | 1.33654 | 0.49114 | 0.71384 | 0.59312 | 0.28404 | 1.79669 | 1.88355 | 1.49834 | 0.000791767 | 0.000791767 | 0.000791767
5 | 103.507 | 1.59515 | 1.40831 | 1.27125 | 0.64343 | 0.75229 | 0.74319 | 0.36453 | 1.74715 | 1.58637 | 1.45234 | 0.000778022 | 0.000778022 | 0.000778022
6 | 120.396 | 1.62432 | 1.33416 | 1.31447 | 0.57084 | 0.61661 | 0.66961 | 0.37207 | 1.61763 | 1.4352 | 1.34462 | 0.000764278 | 0.000764278 | 0.000764278
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
