JohnRSmith101/rocket-tracker/models/yolo/training-runs/yolo11n_60epochs/results.png

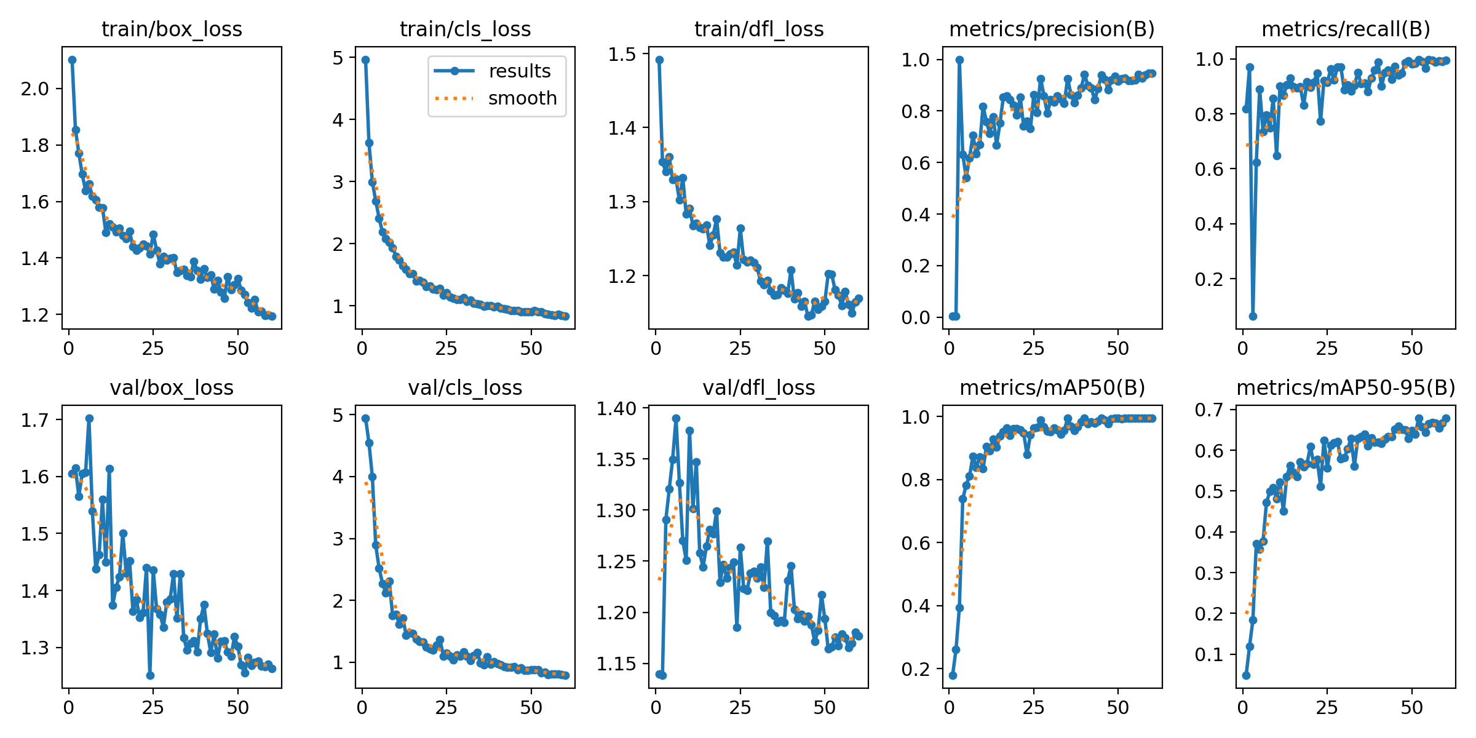
models/yolo/training-runs/yolo11n_60epochs/results.png
