JohnRSmith101/rocket-tracker/models/yolo/training-runs/yolo11n_90epochs_DEPLOYED/results.png

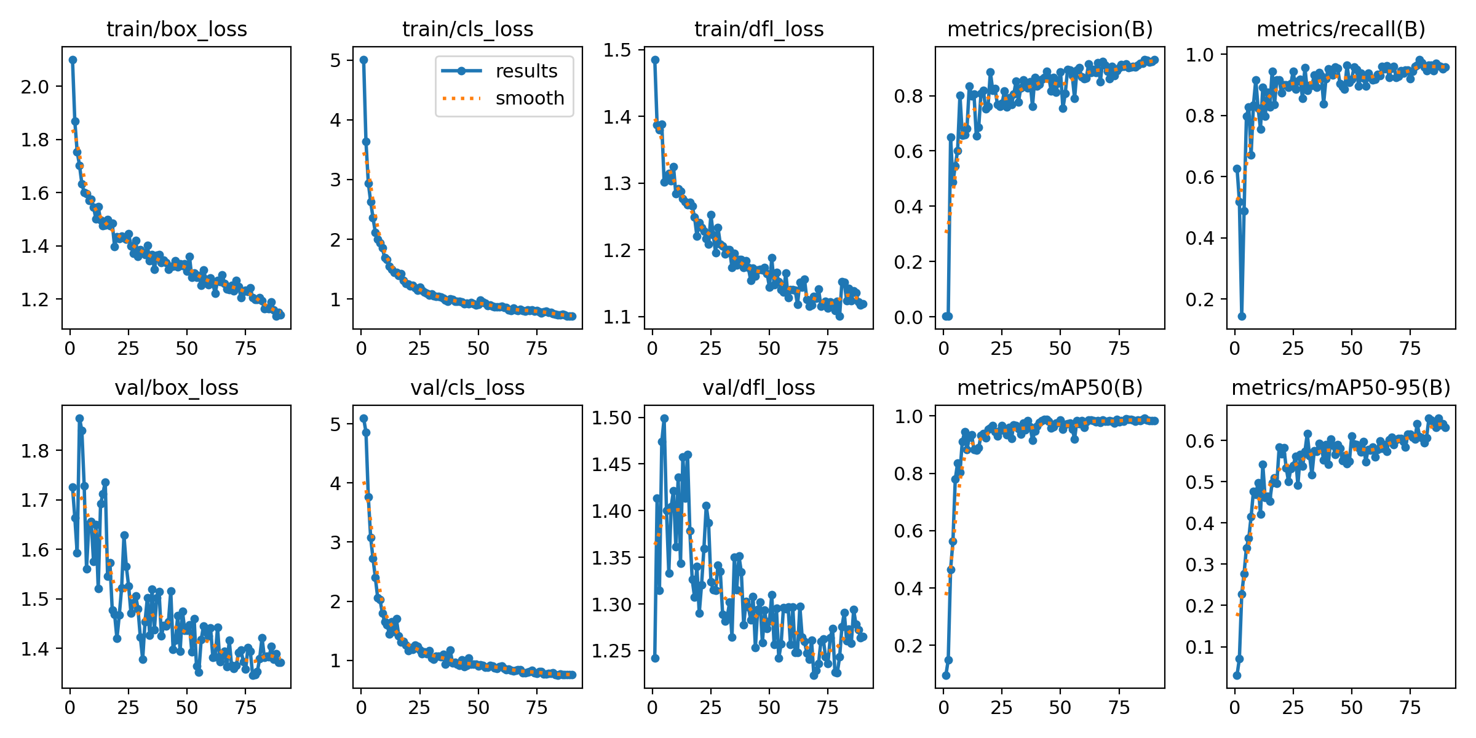
models/yolo/training-runs/yolo11n_90epochs_DEPLOYED/results.png
