JohnRSmith101/rocket-tracker/hardware/kicad/Gimbal_Controller_Lid/Gimbal Controller Lid.kicad_pcb

## KiCad design hardware/kicad/Gimbal_Controller_Lid/Gimbal Controller Lid.kicad_pcb (2026-11-13)

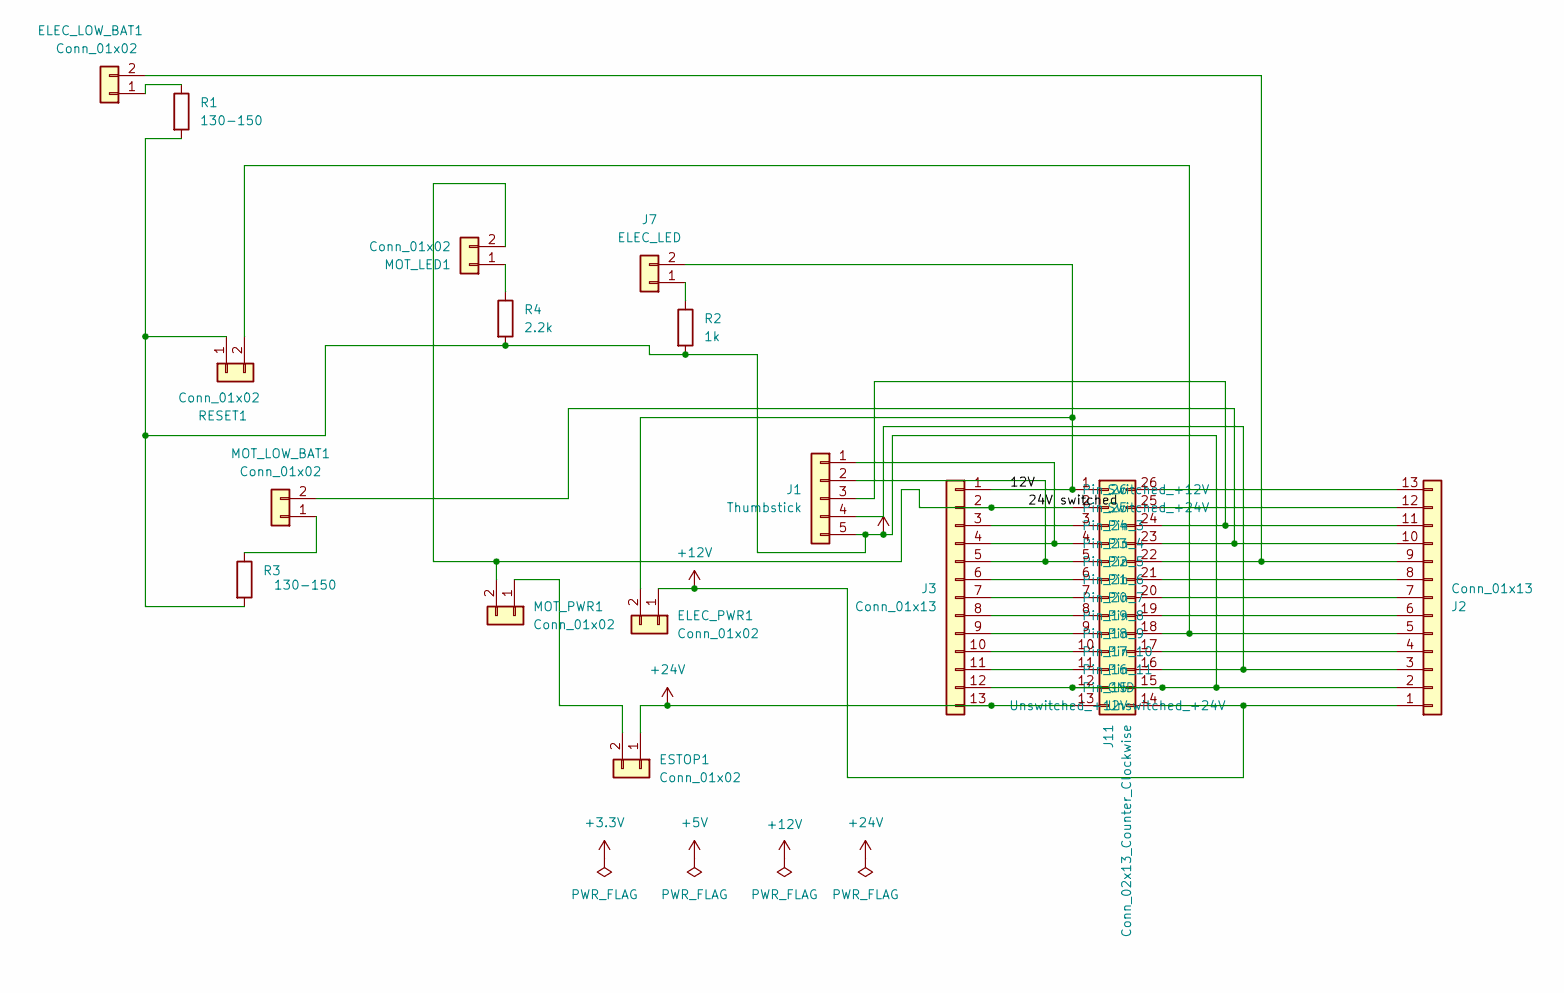
[picture p42: schematic Gimbal Controller Lid.kicad_sch]

Parts:
ELEC_LOW_BAT1: Conn_01x02; PinSocket_1x02_P2.54mm_Vertical
ELEC_PWR1: Conn_01x02; PinSocket_1x02_P2.54mm_Vertical
ESTOP1: Conn_01x02; PinSocket_1x02_P2.54mm_Vertical
J1: Thumbstick; PinHeader_1x05_P2.54mm_Vertical
J2, J3: Conn_01x13; PinSocket_1x13_P2.54mm_Vertical
J7: ELEC_LED; PinSocket_1x02_P2.54mm_Vertical
J11: Conn_02x13_Counter_Clockwise; IDC-Header_2x13_P2.54mm_Vertical
MOT_LED1: Conn_01x02; PinSocket_1x02_P2.54mm_Vertical
MOT_LOW_BAT1: Conn_01x02; PinSocket_1x02_P2.54mm_Vertical
MOT_PWR1: Conn_01x02; PinSocket_1x02_P2.54mm_Vertical
R1, R3: 130-150; R_Axial_DIN0204_L3.6mm_D1.6mm_P7.62mm_Horizontal
R2: 1k; R_Axial_DIN0204_L3.6mm_D1.6mm_P7.62mm_Horizontal
R4: 2.2k; R_Axial_DIN0204_L3.6mm_D1.6mm_P7.62mm_Horizontal
RESET1: Conn_01x02; PinSocket_1x02_P2.54mm_Vertical

Connections:
+5V: J1.5, J2.2, J3.12, J11.12 (GND), J11.15, R1.2, R2.2, R3.2, R4.2, RESET1.1
+12V: ELEC_PWR1.1, J2.1, J11.14 (Unswitched_+12V)
+24V: ESTOP1.1, J3.13, J11.13 (Unswitched_+24V)
/12V: ELEC_PWR1.2, J3.1, J7.2, J11.1 (Switched_+12V)
/24V switched: J3.2, J11.2 (Switched_+24V), MOT_LED1.2, MOT_PWR1.2
unnamed: ELEC_LOW_BAT1.1, R1.1
unnamed: ELEC_LOW_BAT1.2, J2.9, J11.22
unnamed: ESTOP1.2, MOT_PWR1.1
unnamed: J1.1, J3.4, J11.4
unnamed: J1.2, J3.5, J11.5
unnamed: J1.3, J2.11, J11.24
unnamed: J1.4, J2.3, J11.16
unnamed: J7.1, R2.1
unnamed: J3.3, J11.3
unnamed: J3.6, J11.6
unnamed: J3.7, J11.7
unnamed: J3.8, J11.8
unnamed: J3.9, J11.9
unnamed: J3.10, J11.10
unnamed: J3.11, J11.11
unnamed: J2.4, J11.17
unnamed: J2.5, J11.18, RESET1.2
unnamed: J2.6, J11.19
unnamed: J2.7, J11.20
unnamed: J2.8, J11.21
unnamed: J2.10, J11.23, MOT_LOW_BAT1.2
unnamed: J2.12, J11.25
unnamed: J2.13, J11.26
unnamed: MOT_LED1.1, R4.1
unnamed: MOT_LOW_BAT1.1, R3.1

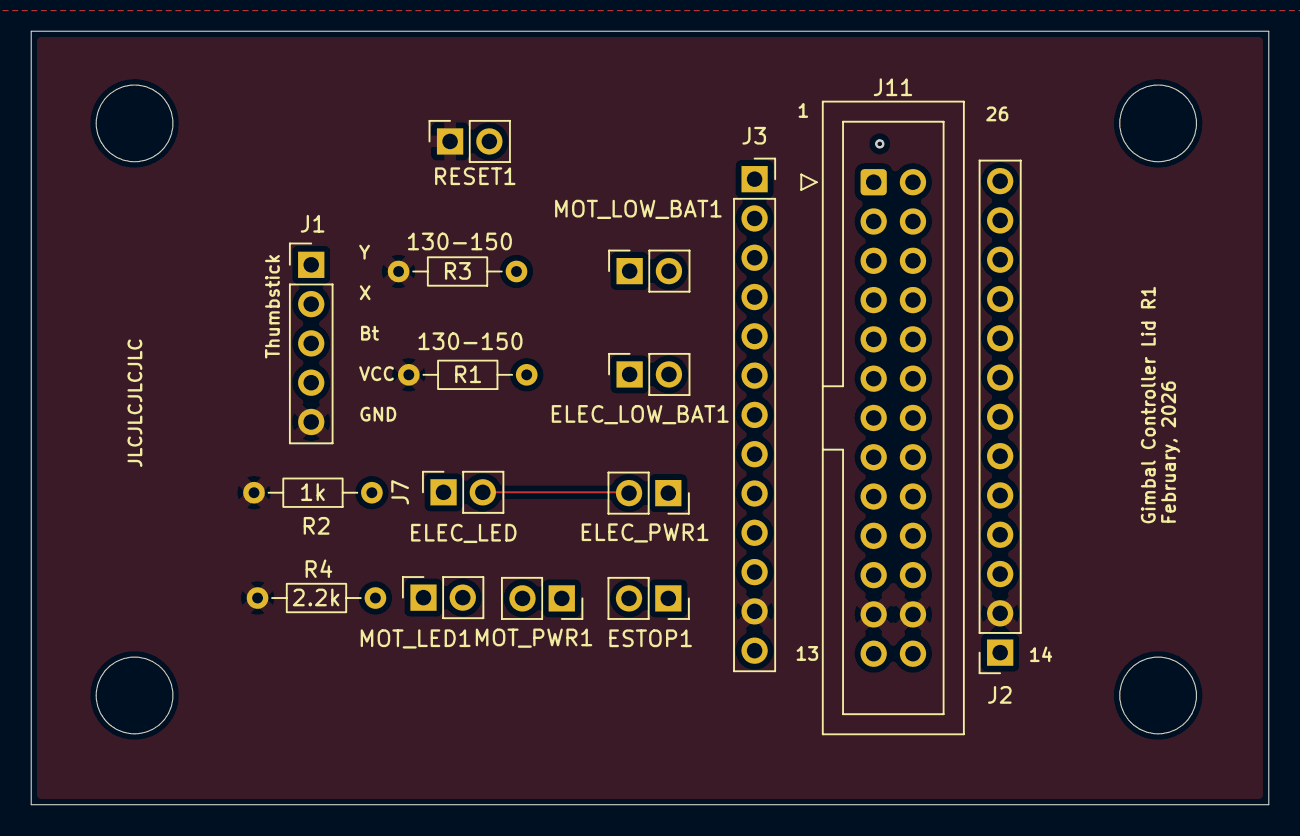
[picture p43: board Gimbal Controller Lid.kicad_pcb from above]

Board: 4 copper layers, 80.0 x 50.0 mm, 16 parts (0 on the bottom side), 30 nets.
