JohnRSmith101/rocket-tracker/hardware/kicad/Gimbal_Controller_Box_R1/Gimbal Controller Box R1.kicad_pcb

## KiCad design hardware/kicad/Gimbal_Controller_Box_R1/Gimbal Controller Box R1.kicad_pcb (2026-11-13)

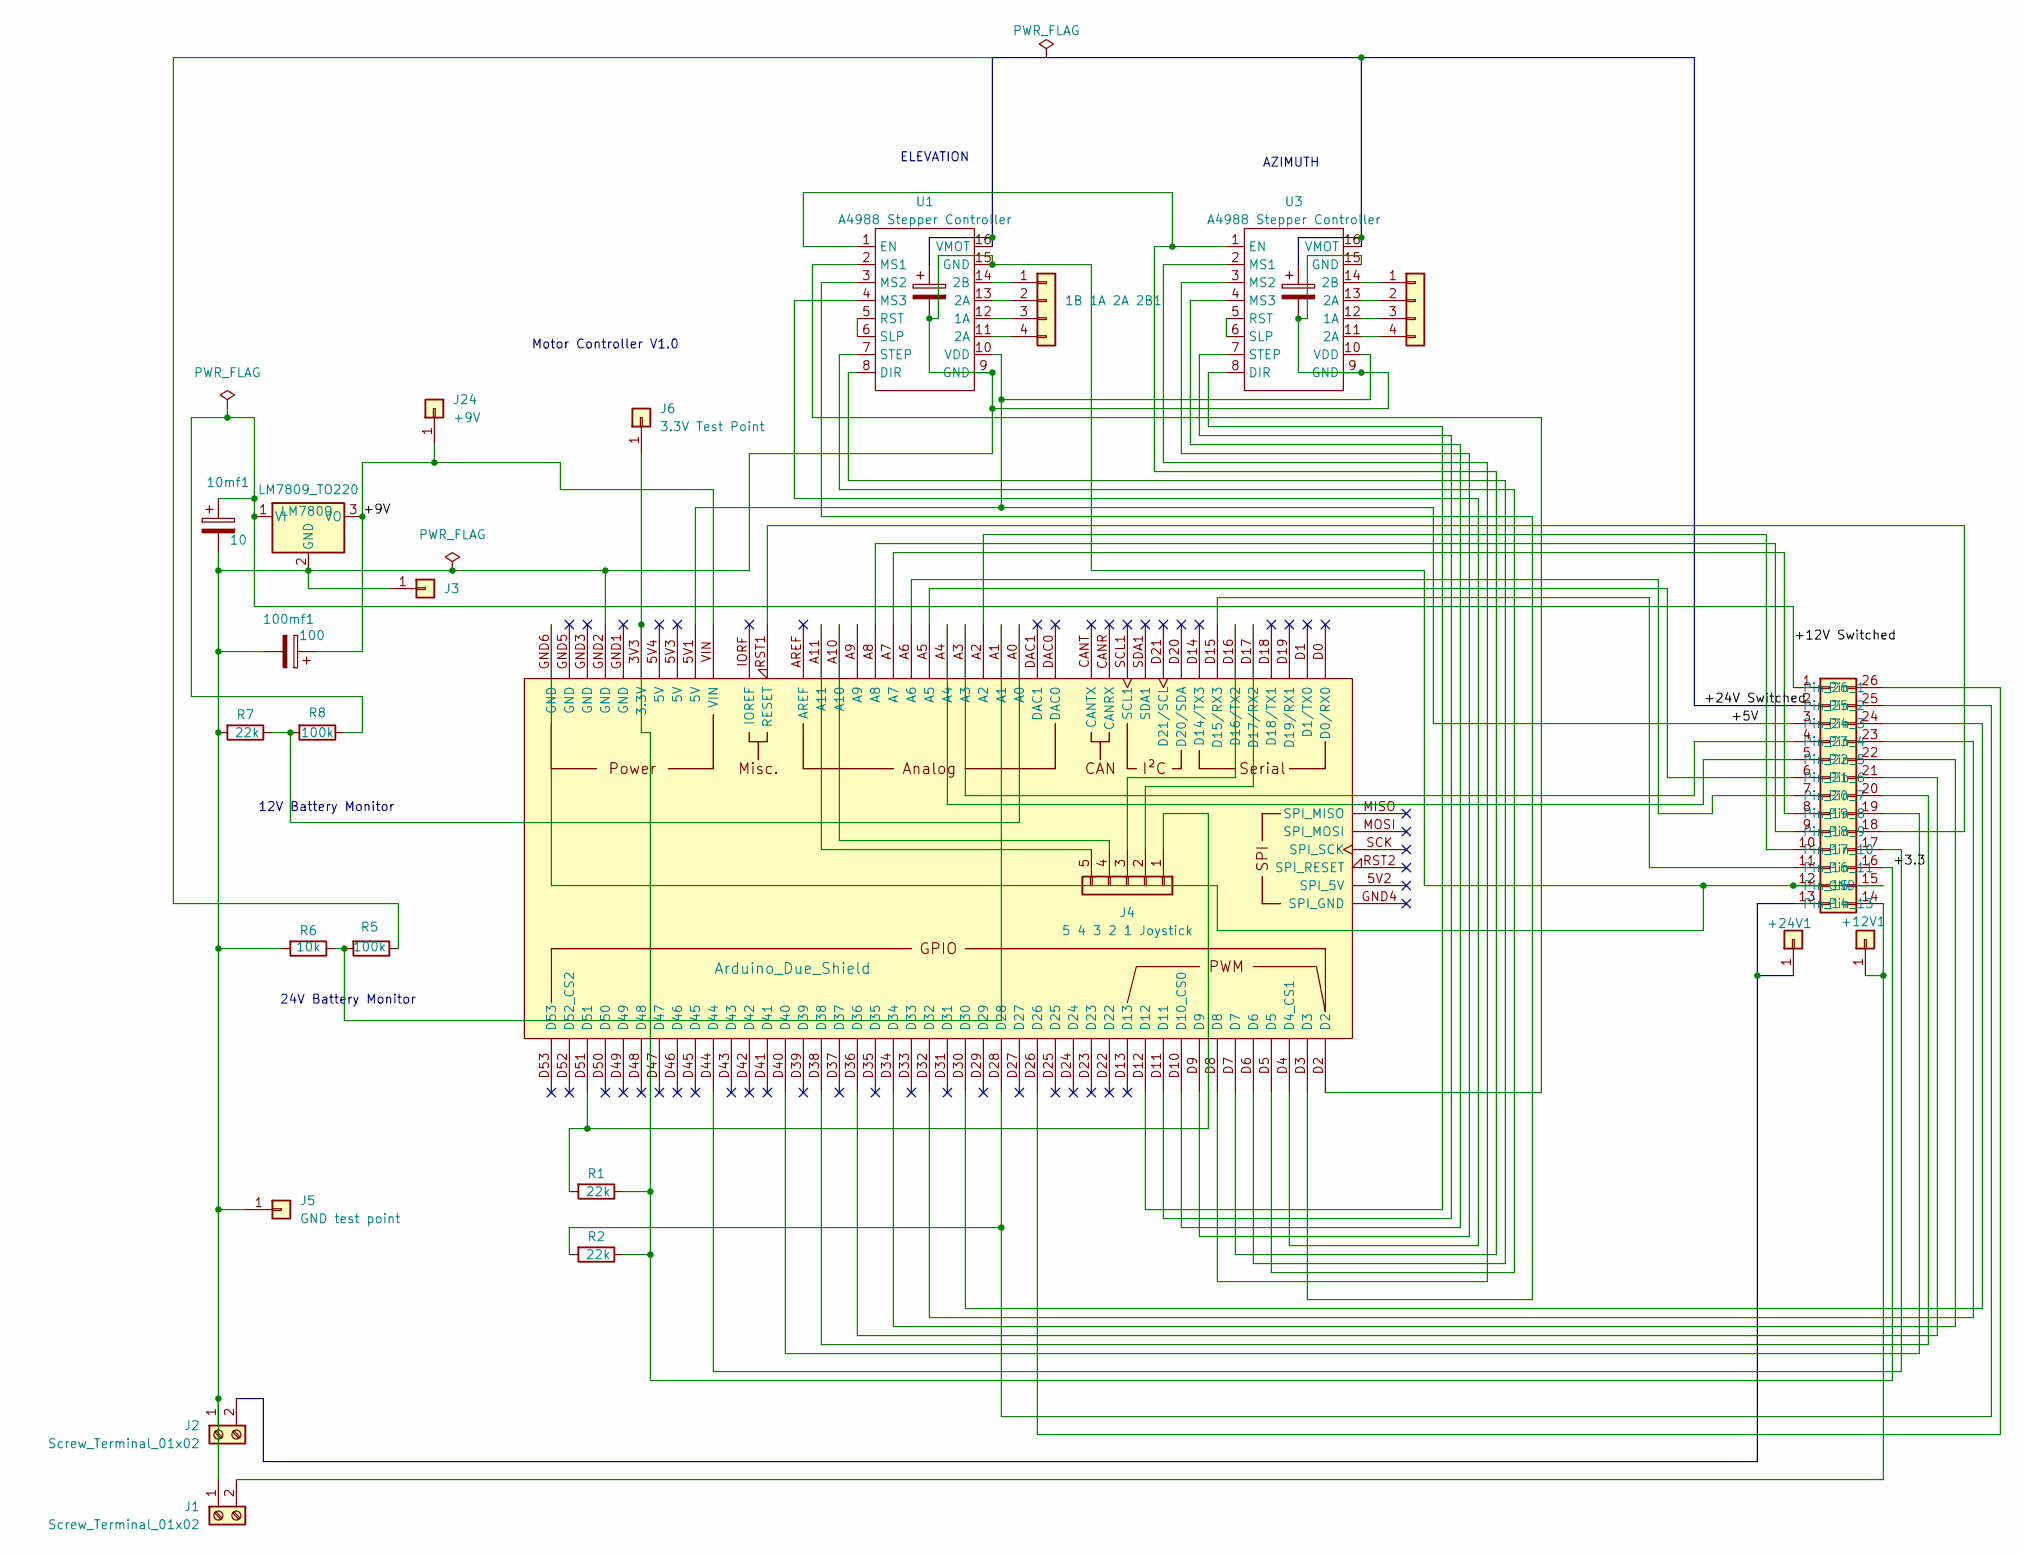
[picture p44: schematic Gimbal Controller Box R1.kicad_sch]

Parts:
1B 1A 2A 2B1, 1B 1A 2A 2B2: Conn_01x04; PinSocket_1x04_P2.54mm_Vertical
10mf1: 10; CP_Radial_D5.0mm_P2.50mm
100mf1: 100; CP_Radial_D5.0mm_P2.50mm
+12V1, +24V1: Conn_01x01; PinHeader_1x01_P2.54mm_Vertical
A1: Arduino_Due_Shield
C1, C6: C_Polarized; CP_Radial_D5.0mm_P2.50mm
J1, J2: Screw_Terminal_01x02; Altech_AK100_1x02_P5.00mm
J3: GND; PinHeader_1x01_P2.54mm_Vertical
J4: 5 4 3 2 1 Joystick; PinHeader_1x05_P2.54mm_Vertical
J5: GND test point; PinHeader_1x01_P2.54mm_Vertical
J6: 3.3V Test Point; PinHeader_1x01_P2.54mm_Vertical
J11: Conn_02x13_Counter_Clockwise; IDC-Header_2x13_P2.54mm_Vertical
J24: +9V; PinHeader_1x01_P2.54mm_Vertical
LM7809: LM7809_TO220; TO-220-3_Vertical
R1, R2, R7: 22k; R_Axial_DIN0207_L6.3mm_D2.5mm_P7.62mm_Horizontal
R5, R8: 100k; R_Axial_DIN0207_L6.3mm_D2.5mm_P7.62mm_Horizontal
R6: 10k; R_Axial_DIN0207_L6.3mm_D2.5mm_P7.62mm_Horizontal
U1, U3: A4988 Stepper Controller; A4988 Controller (Alternate)

Connections:
/+3.3: A1.3V3 (3.3V), J6.1, J11.16, R1.1, R2.1
/+5V: A1.5V1 (5V), J11.3, U1.10 (VDD), U3.10 (VDD)
/+9V: 100mf1.1, A1.VIN, J24.1, LM7809.3 (VO)
/+12V Switched: 10mf1.1, J11.1, LM7809.1 (VI), R8.1
/+24V Switched: C1.1, C6.1, J11.2, U1.16 (VMOT), U3.16 (VMOT)
unnamed: 1B 1A 2A 2B1.1, U1.14 (2B)
unnamed: 1B 1A 2A 2B1.2, U1.13 (2A)
unnamed: 1B 1A 2A 2B1.3, U1.12 (1A)
unnamed: 1B 1A 2A 2B1.4, U1.11 (2A)
unnamed: 1B 1A 2A 2B2.1, U3.14 (2B)
unnamed: 1B 1A 2A 2B2.2, U3.13 (2A)
unnamed: 1B 1A 2A 2B2.3, U3.12 (1A)
unnamed: 1B 1A 2A 2B2.4, U3.11 (2A)
unnamed: +12V1.1, J1.2, J11.14
unnamed: +24V1.1, J2.2, J11.13
unnamed: A1.D4 (D4_CS1), U1.4 (MS3)
unnamed: A1.D10 (D10_CS0), U3.4 (MS3)
unnamed: A1.D15 (D15/RX3), J11.11
unnamed: A1.D16 (D16/TX2), J4.3
unnamed: A1.D17 (D17/RX2), J4.2
unnamed: A1.A0, R7.1, R8.2
unnamed: A1.A1, R5.2, R6.1
unnamed: A1.RST1 (RESET), J11.18
unnamed: 10mf1.2, 100mf1.2, A1.GND2 (GND), A1.GND6 (GND), C1.2, C6.2, J1.1, J2.1, J3.1, J5.1, J11.12 (GND), J11.15, LM7809.2 (GND), R6.2, R7.2, U1.9 (GND), U1.15 (GND), U3.9 (GND), U3.15 (GND)
unnamed: A1.D51, J4.1, R1.2
unnamed: A1.A10, J4.4
unnamed: A1.A11, J4.5
unnamed: A1.A3, J11.4
unnamed: A1.A4, J11.5
unnamed: A1.A5, J11.6
unnamed: A1.A6, J11.7
unnamed: A1.A7, J11.8
unnamed: A1.A8, J11.9
unnamed: A1.A2, J11.10
unnamed: A1.D44, J11.17
unnamed: A1.D40, J11.19
unnamed: A1.D38, J11.20
unnamed: A1.D36, J11.21
unnamed: A1.D34, J11.22
unnamed: A1.D32, J11.23
unnamed: A1.D30, J11.24
unnamed: A1.D28, J11.25, R2.2
unnamed: A1.D26, J11.26
unnamed: A1.D6, U1.8 (DIR)
unnamed: A1.D7, U1.1 (EN), U3.1 (EN)
unnamed: A1.D2, U1.2 (MS1)
unnamed: A1.D3, U1.3 (MS2)
unnamed: U1.5 (RST), U1.6 (SLP)
unnamed: A1.D5, U1.7 (STEP)
unnamed: A1.D12, U3.8 (DIR)
unnamed: A1.D8, U3.2 (MS1)
unnamed: A1.D9, U3.3 (MS2)
unnamed: U3.5 (RST), U3.6 (SLP)
unnamed: A1.D11, U3.7 (STEP)

Notes on the sheet:
AZIMUTH
24V Battery Monitor
12V Battery Monitor
ELEVATION
Motor Controller V1.0

Board: 4 copper layers, 26 parts (0 on the bottom side), 54 nets, no tracks yet.
