JohnRSmith101/rocket-tracker/(notices)

Notices in the files:
software/tracker-yolo/SVProTracker_YOLO_NCNN_R2_Video_Data_Log.py:
This program is free software: you can redistribute it and/or modify
it under the terms of the GNU Affero General Public License as
published by the Free Software Foundation, version 3 of the License.
